Kevin-WSCU/96Boards-Camera/Boards/IMG_3235.jpg

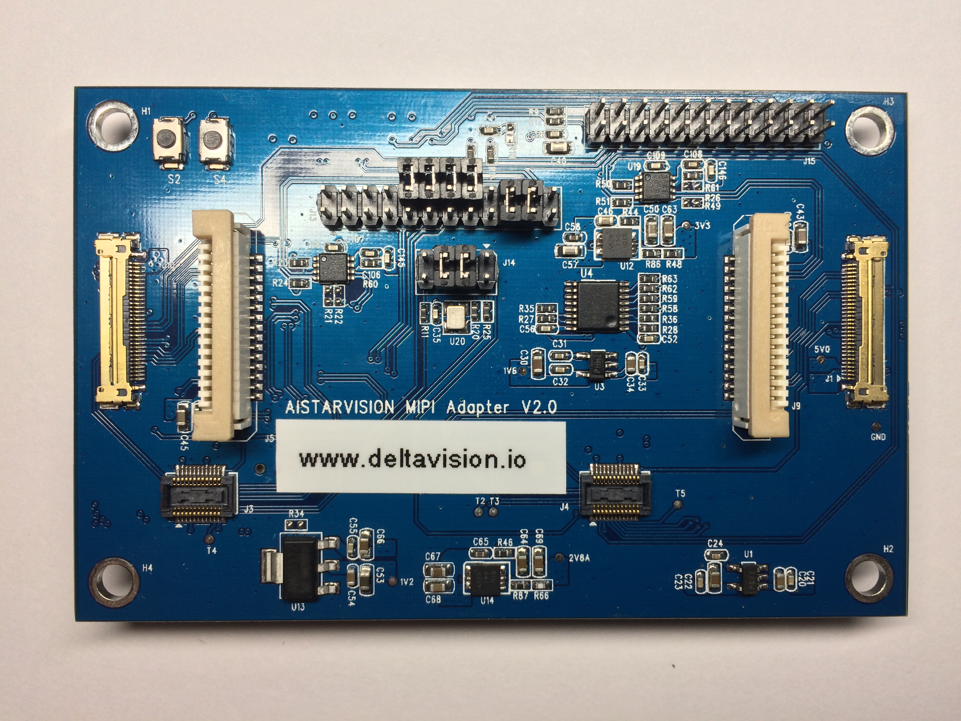
Boards/IMG_3235.jpg
