Kevin-WSCU/96Boards-Camera/Boards/IMG_3196.jpg

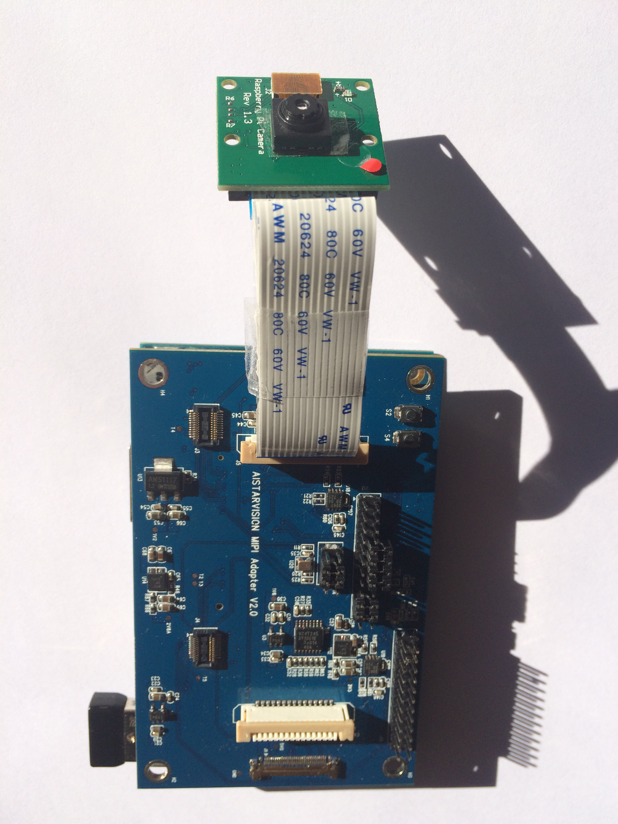
Boards/IMG_3196.jpg
