Kevin-WSCU/96Boards-Camera/README.md

This is the AISTARVISION MIPI Adapter,V2.0! It's updated from V1.0,with the goal of two CSI2 port support.Still,it's only for 96boards CE Edition.Our goal is to make 96Boards support variety of image sensors,include SOC sensor and raw bayer sensor.

P.S. AISTARVISION has joined DeltaVision team which has the same passion and mission to bring camera everywhere,making your project smarter than ever before.Take a look at our site for more interesting cameras:

https://www.deltavision.io

Sensor sample drivers available in Debian 16.09 for Dragonboard410C:[Dragonboard410C Camera](https://github.com/Kevin-WSCU/Debian-169.git)

Image sensor support list(Default on Debian):

1)OV5645:2592*1944@15fps,1920*1080@30fps,1280*960@30fps

2)OV5640:2592*1944@15fps,1920*1080@30fps,1280*960@30fps

3)OV7251:640*480@100fps

4)MT9V024 with Toshiba MIPI Bridge:752*480@60fps

5)IMX185:1080p@60fps

6)AP0202+AR0230:1080p@30fps,WDR

7)OV13850 supported by Android

8)OV8865 supported by Android

9)Raspberry PI camera V1.3(OV5647),supported by Android

10)Raspberry PI camera V1.3(IMX219),supported by Android

11)MT9M034 with Toshiba MIPI Bridge:RAW12

12)MT9M031 with Toshiba MIPI Bridge:RAW12

13)AR0130 with Toshiba MIPI Bridge:RAW12

14)AR0134 with Toshiba MIPI Bridge:RAW12

15)AR0144 :RAW12

16)OV9281:RAW8/RAW10

Check our ebay store for available items: [Deltavision Store on Ebay](https://www.ebay.com/sch/aiwills-8/m.html?item=252956476095&rt=nc&_trksid=p2047675.l2562)

You can find pre-built sensor drivers for all avaiable cameras:[Pre-built](Pre-built)
