Kevin-WSCU/96Boards-Camera/Pre-built/Android_5.1.1/imx219/README

Raspberry imx219 camera module is supported on mipi csi2 15pin interface of Adapter V2.0 Mezzanine board.
