Kevin-WSCU/96Boards-Camera/Pre-built/Android_5.1.1/ov5647/README

Raspberry ov5647 camera module is supported on 15pin mipi csi2 interface of Adapter V2.0 Mezzanine board.
