Kevin-WSCU/96Boards-Camera/Pre-built/Android_5.1.1/Dual_concurrent_ov5645/README

1.Android 5.1.1 image location

http://builds.96boards.org/releases/dragonboard410c/qualcomm/android/16.03/
download dragonboard410c_sdcard_install_android-99.zip

2.Source code

  ** Qualcomm BSP

    https://developer.qualcomm.com/download/db410c/android_board_support_package_vla.br_.1.2.4-01810-8x16.0-3.zip

  ** Aurora Code download guide

    https://developer.qualcomm.com/download/db410c/linux-android-software-build-and-installation-guide.pdf

3.Modification

  ** software:

    Fastboot flash boot boot_dual_concurrent_ov5645.img
    adb push libmmcamera_ov5645_rear.so
    adb push libmmcamera2_isp_modules.so
    adb push liboemcamera.so
    adb push libmmcamera2_iface_modules.so

  ** hardware(refer to AISTARVISION MIPI Adapter V2.0_release.pdf):

    Rear ov5645 module is connected to J3 on MIPI adapter, connect I2C2_SDA/SCL to CAM1_SDA/SCL on MIPI adapter V2.0.
    Front ov5645 module is connected to J4 on MIPI adapter, connect I2C2_SDA/SCL to CAM2_SDA/SCL on MIPI adapter V2.0.
