Kevin-WSCU/96Boards-Camera/Boards/IMG_2752.jpg

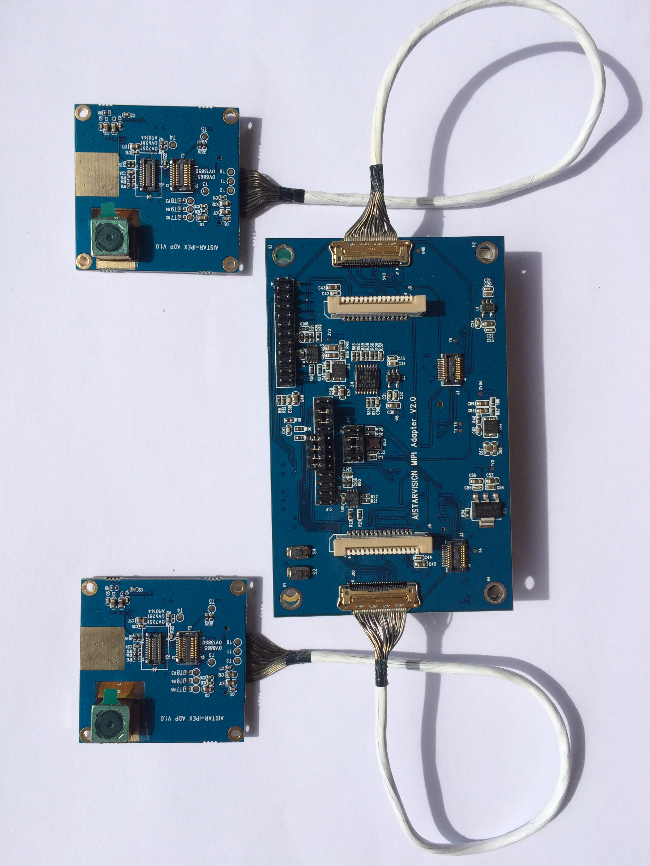
Boards/IMG_2752.jpg
