Kevin-WSCU/96Boards-Camera/Boards/IMG_3036.jpg

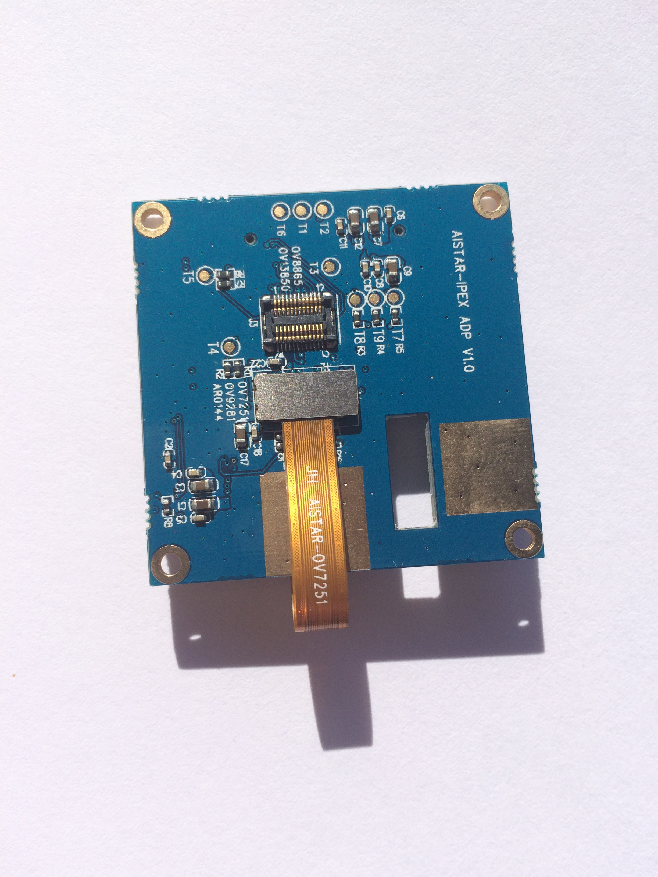
Boards/IMG_3036.jpg
