Kevin-WSCU/96Boards-Camera/Boards/IMG_3037.jpg

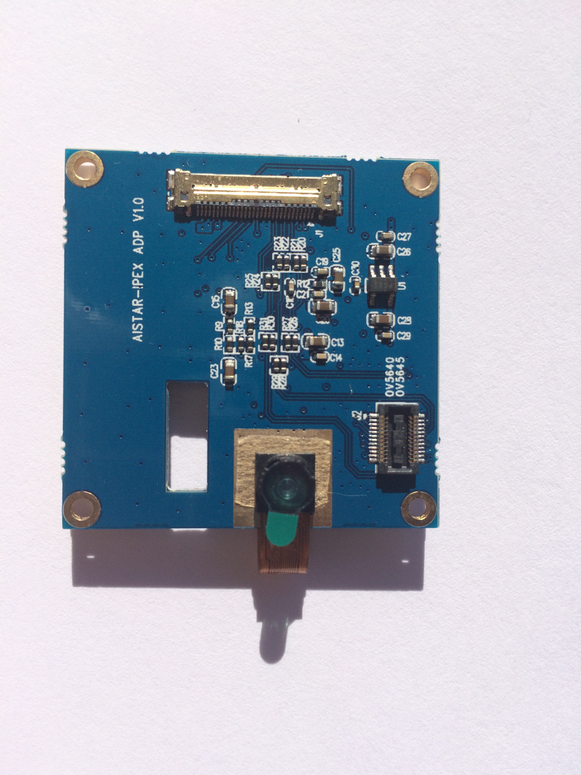
Boards/IMG_3037.jpg
