Kevin-WSCU/96Boards-Camera/Boards/IMG_3038.jpg

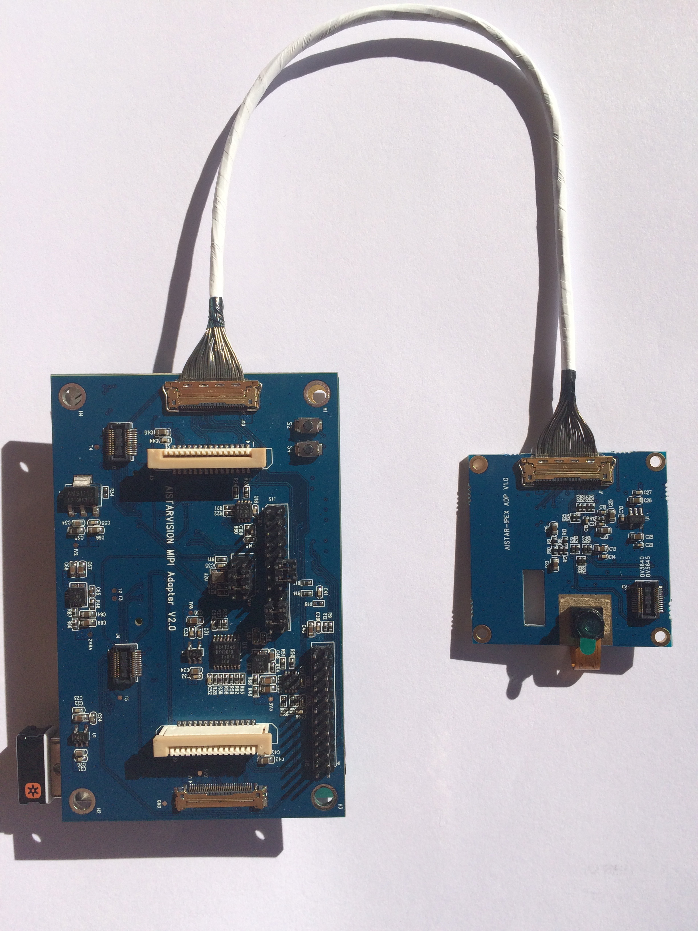
Boards/IMG_3038.jpg
