Kevin-WSCU/96Boards-Camera/Boards/IMG_3039.jpg

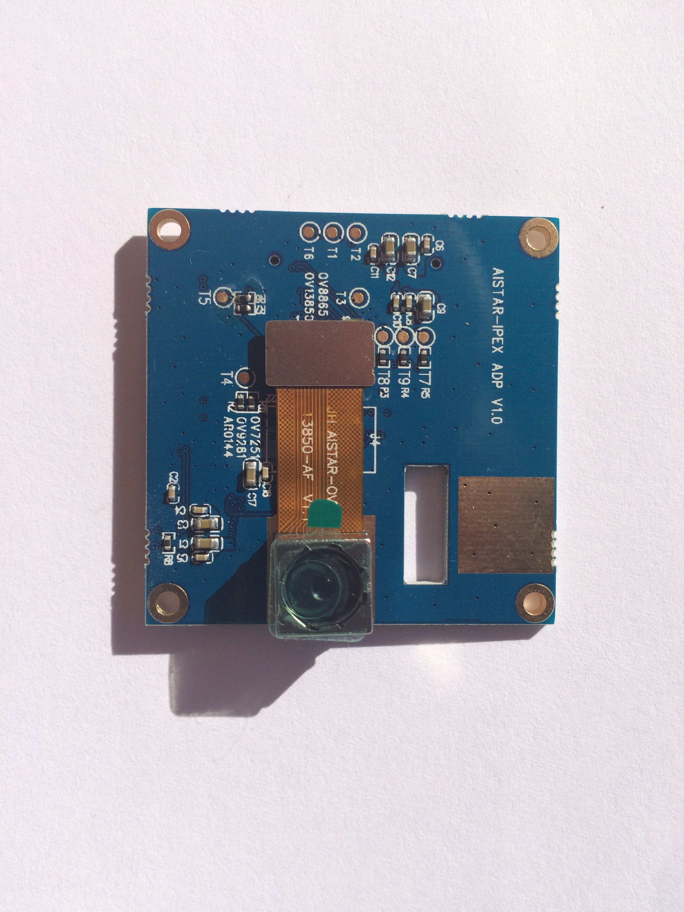
Boards/IMG_3039.jpg
