Kevin-WSCU/96Boards-Camera/Boards/IMG_3040.jpg

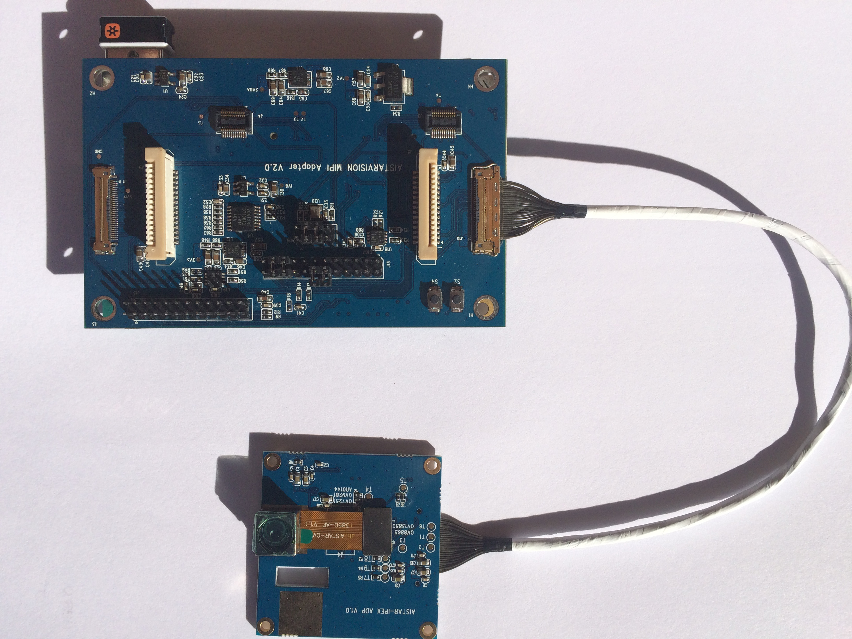
Boards/IMG_3040.jpg
