Kevin-WSCU/96Boards-Camera/Boards/IMG_3052.jpg

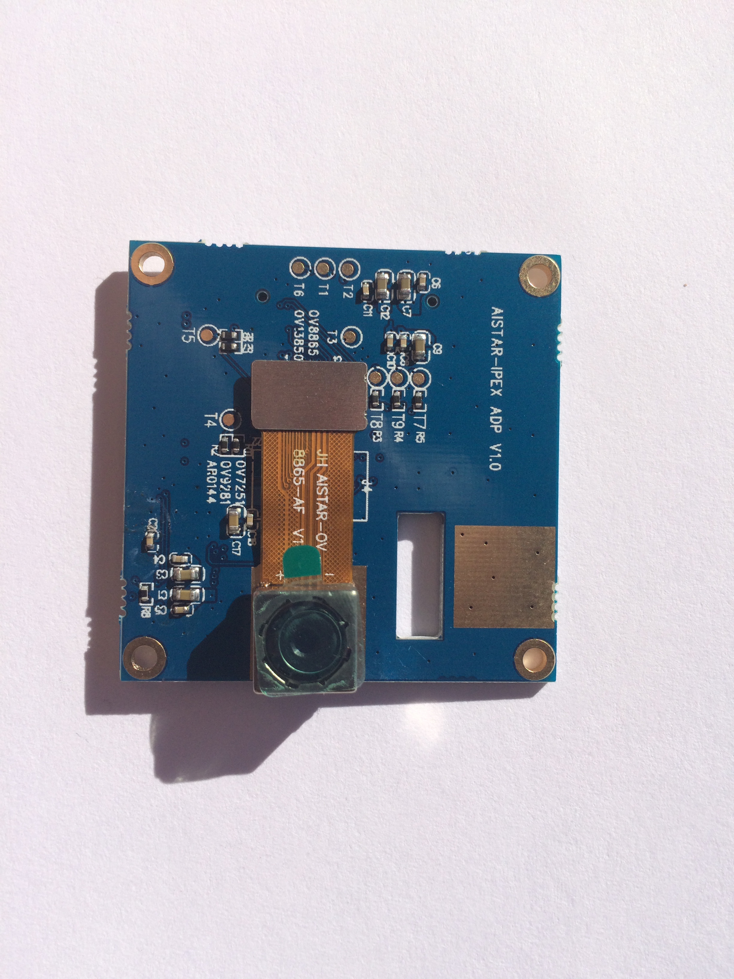
Boards/IMG_3052.jpg
