Kevin-WSCU/96Boards-Camera/Boards/IMG_3053.jpg

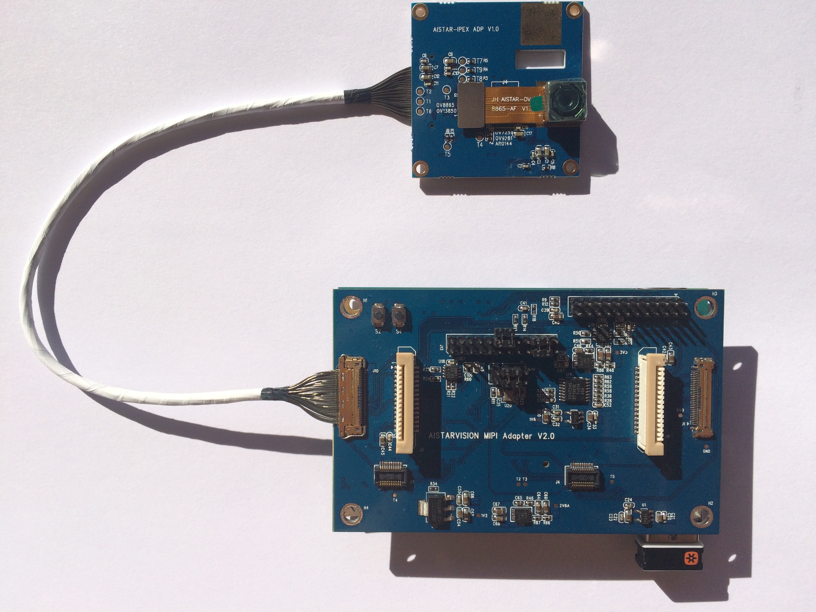
Boards/IMG_3053.jpg
