Kevin-WSCU/96Boards-Camera/Boards/IMG_3056.jpg

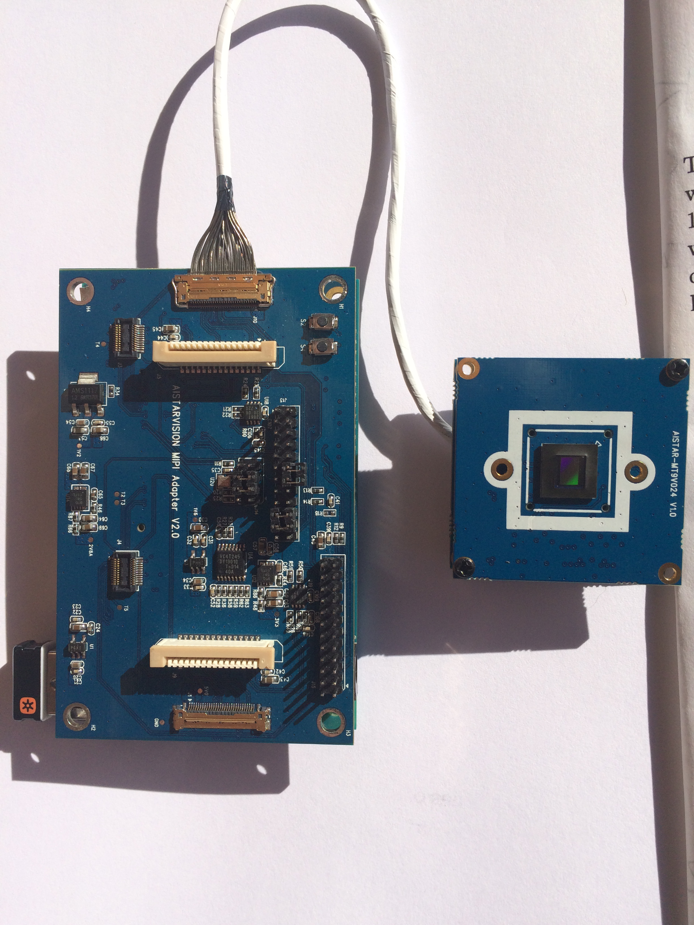
Boards/IMG_3056.jpg
