Kevin-WSCU/96Boards-Camera/Boards/IMG_3057.jpg

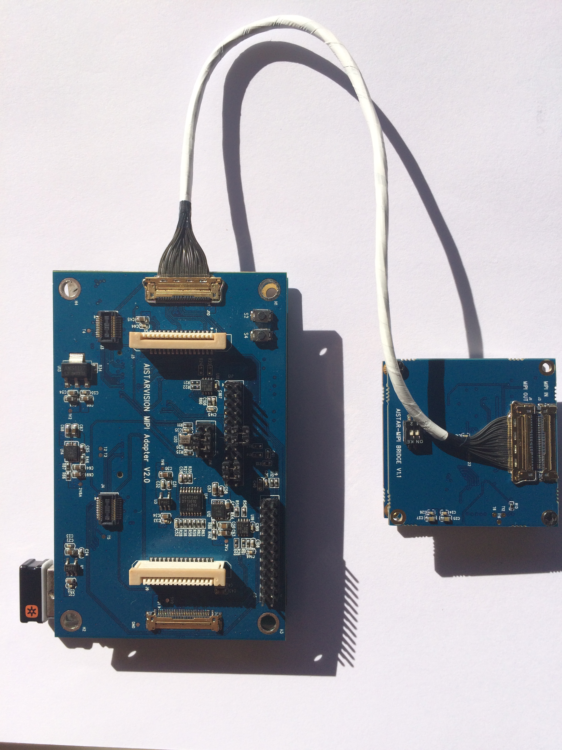
Boards/IMG_3057.jpg
