Kevin-WSCU/96Boards-Camera/Boards/IMG_3221.jpg

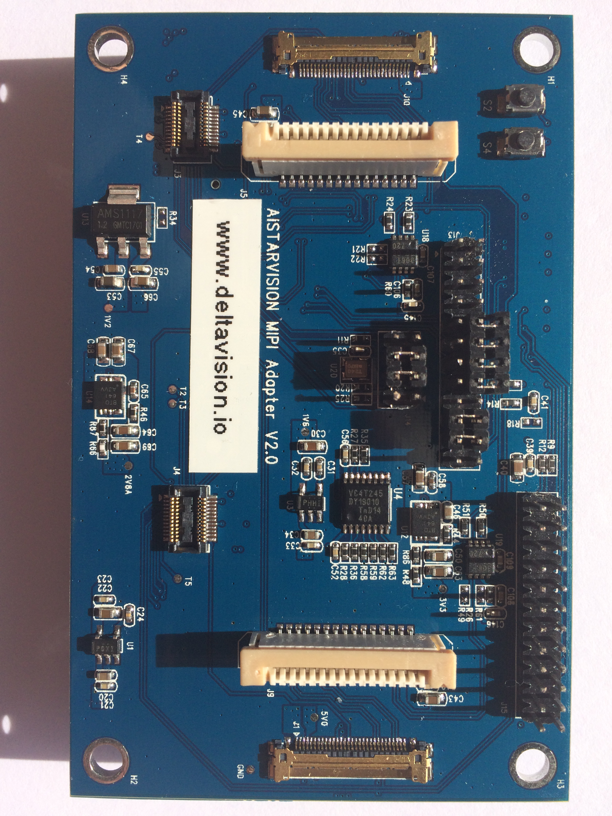
Boards/IMG_3221.jpg
