Kevin-WSCU/96Boards-Camera/Boards/IMG_3222.jpg

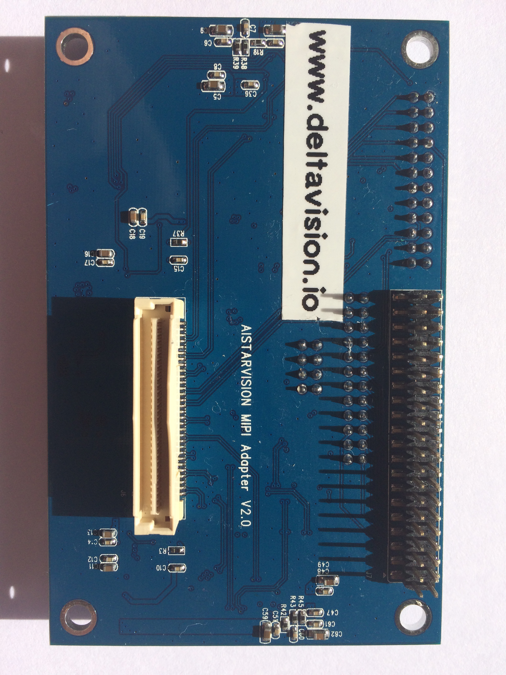
Boards/IMG_3222.jpg
