Kevin-WSCU/96Boards-Camera/Boards/IMG_3230.jpg

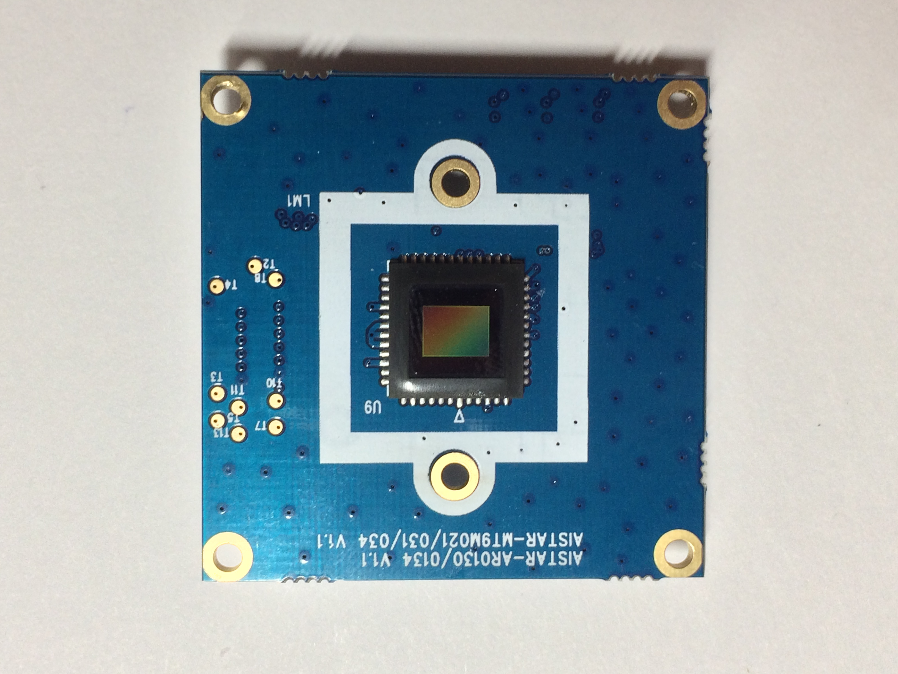
Boards/IMG_3230.jpg
