Kevin-WSCU/96Boards-Camera/Boards/IMG_3237.jpg

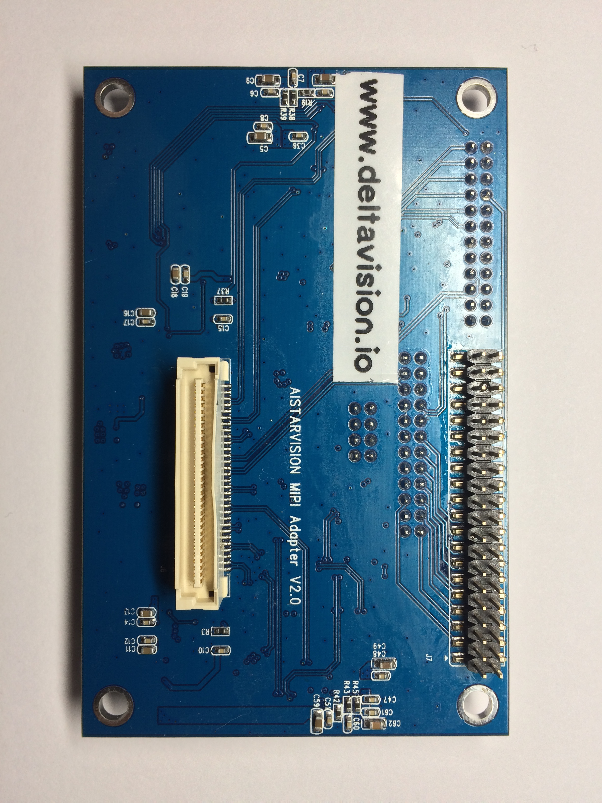
Boards/IMG_3237.jpg
