Kevin-WSCU/96Boards-Camera/Boards/IMG_3243.jpg

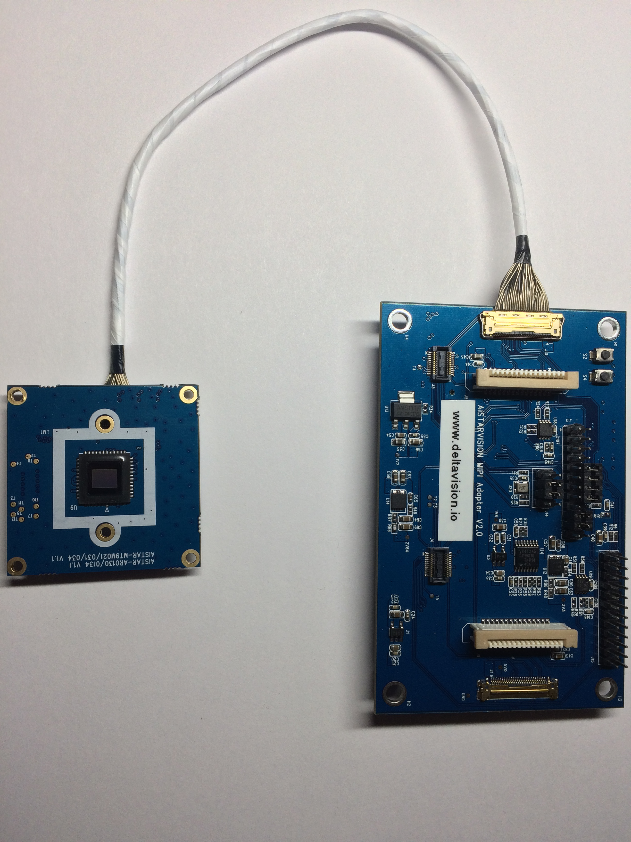
Boards/IMG_3243.jpg
