Kevin-WSCU/96Boards-Camera/Pre-built/Android_5.1.1/Dual_concurrent_ov5645/dual_concurrent_ov5645_preview.jpg

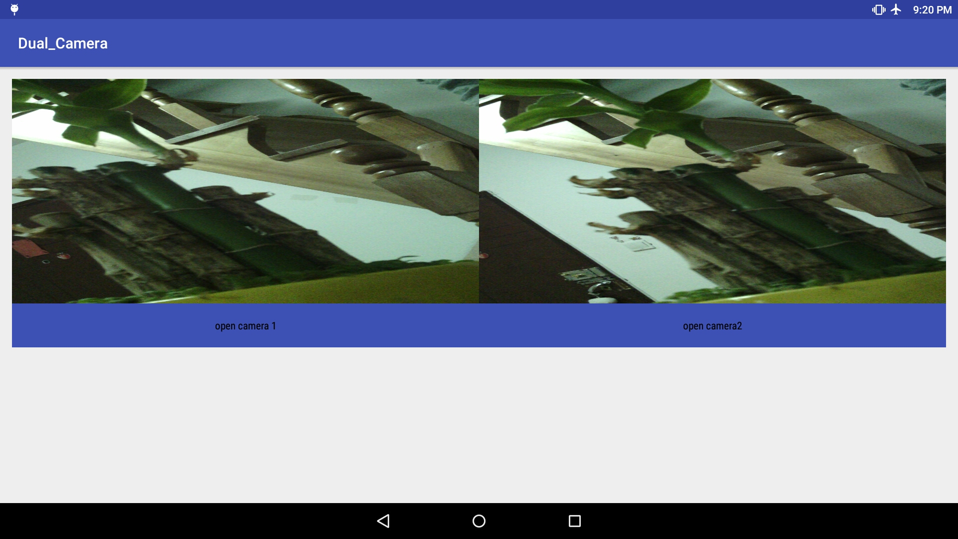
Pre-built/Android_5.1.1/Dual_concurrent_ov5645/dual_concurrent_ov5645_preview.jpg
