Kevin-WSCU/96Boards-Camera/SensorModuleSpec/AISTAR-MIPI-Bridge V1.2.pdf

1.8V IO | 3.3V IO

## DIR=0, A<-B

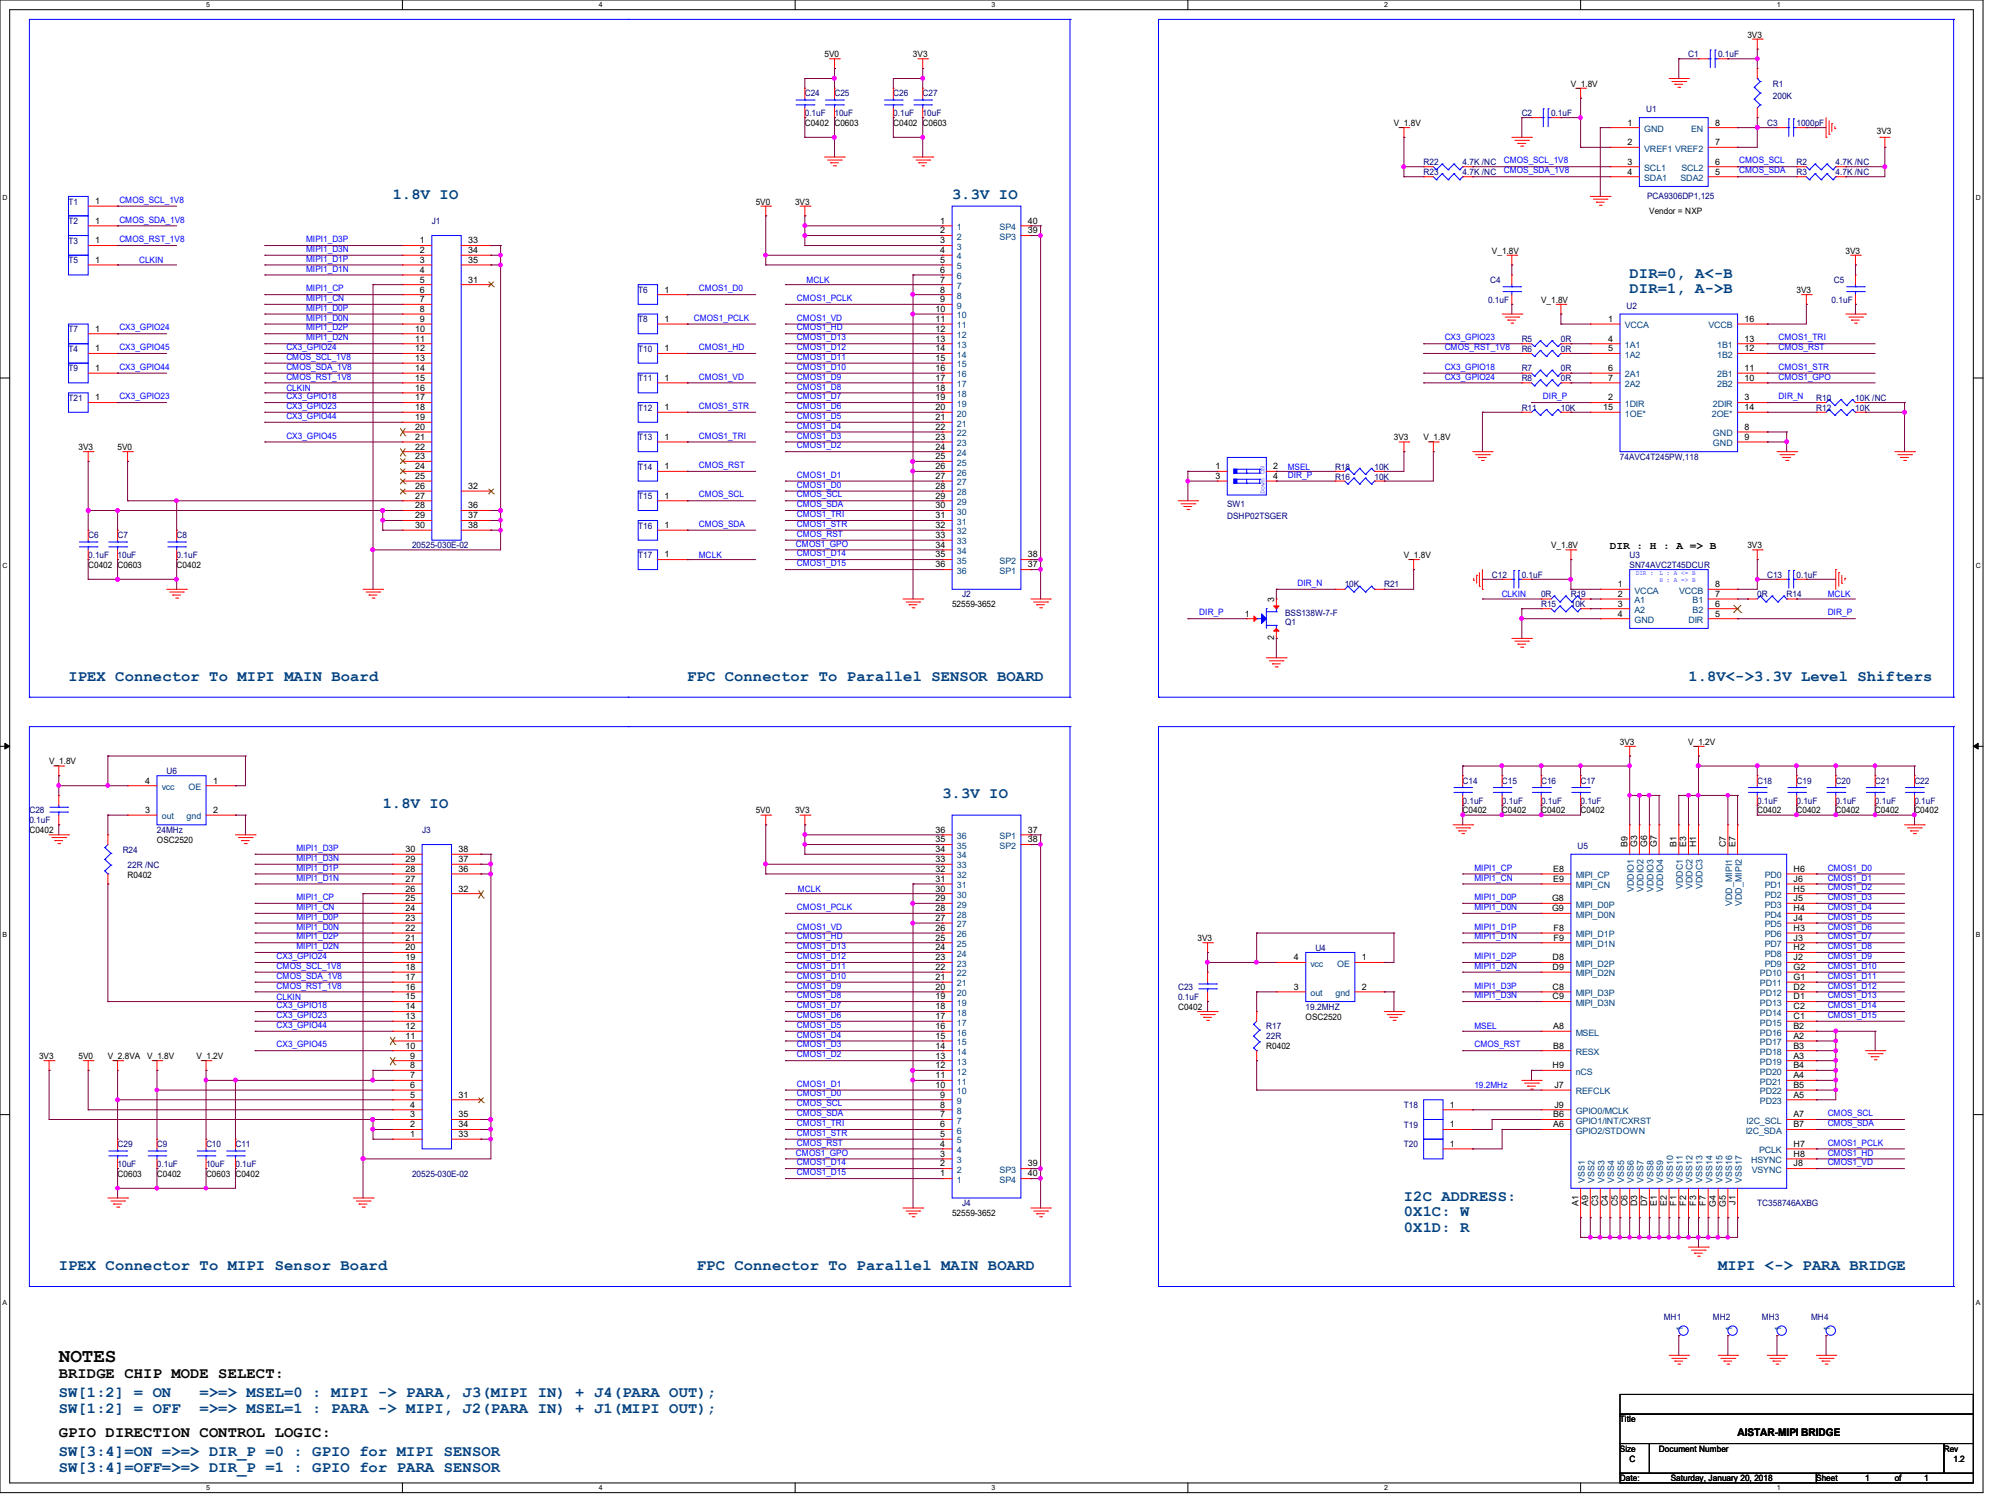
[picture p27: page 1]

IPEX Connector To MIPI MAIN Board

FPC Connector To Parallel SENSOR BOARD

IPEX Connector To MIPI Sensor Board

FPC Connector To Parallel MAIN BOARD

NOTES
BRIDGE CHIP MODE SELECT:

GPIO DIRECTION CONTROL LOGIC:
SW[3:4]=ON =>=> DIR_P =0 : GPIO for MIPI SENSOR
SW[3:4]=OFF=>=> DIR_P =1 : GPIO for PARA SENSOR

5

4

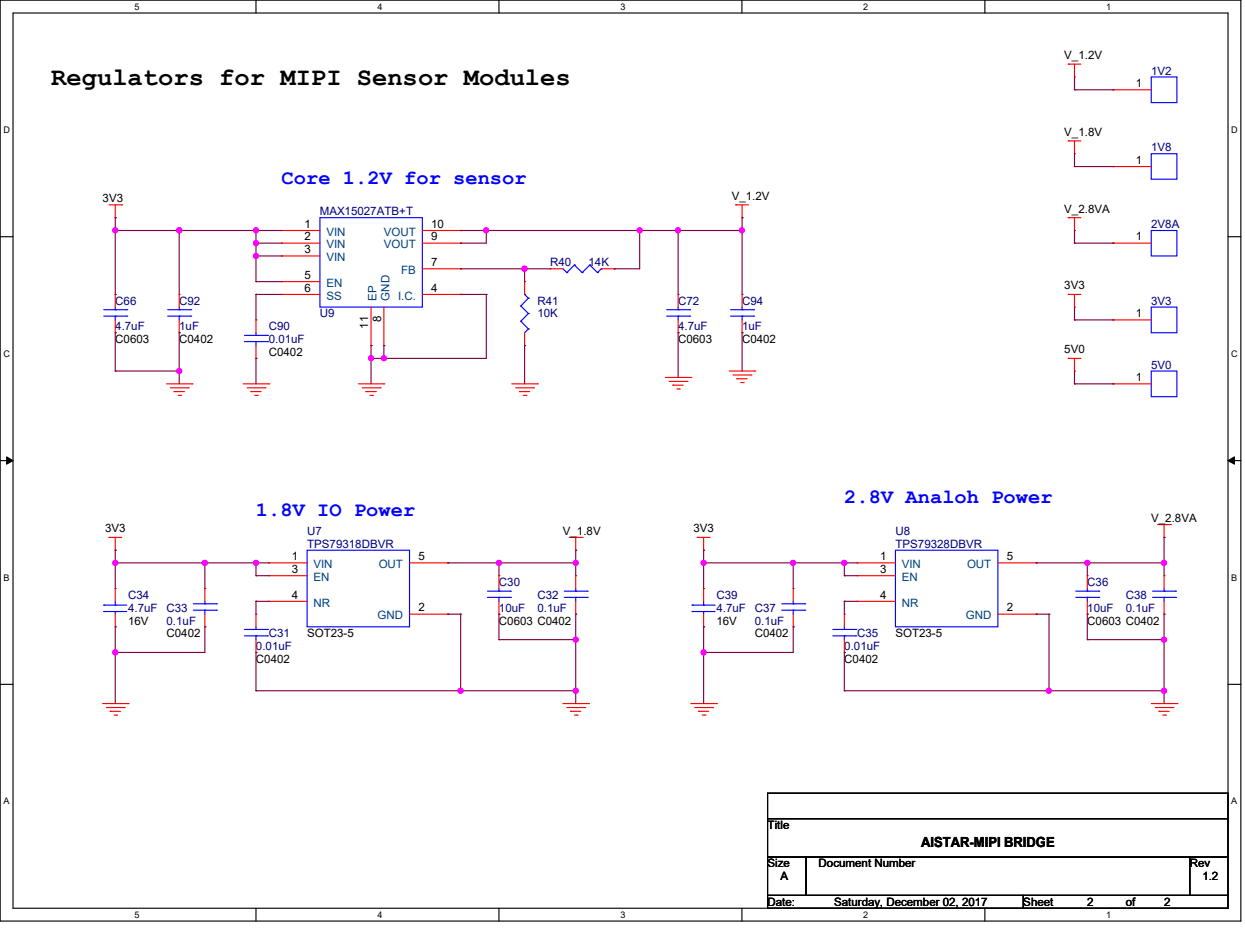
[picture p28: page 2]

Regulators for MIPI Sensor Modules

GND 8 VOUT 9 VOUT 10 EP 11
