Kevin-WSCU/96Boards-Camera/SensorModuleSpec/AISTAR-AR0134 V1.1.pdf

## FPC CONNECTOR PARALLEL OUT 2.8V IO

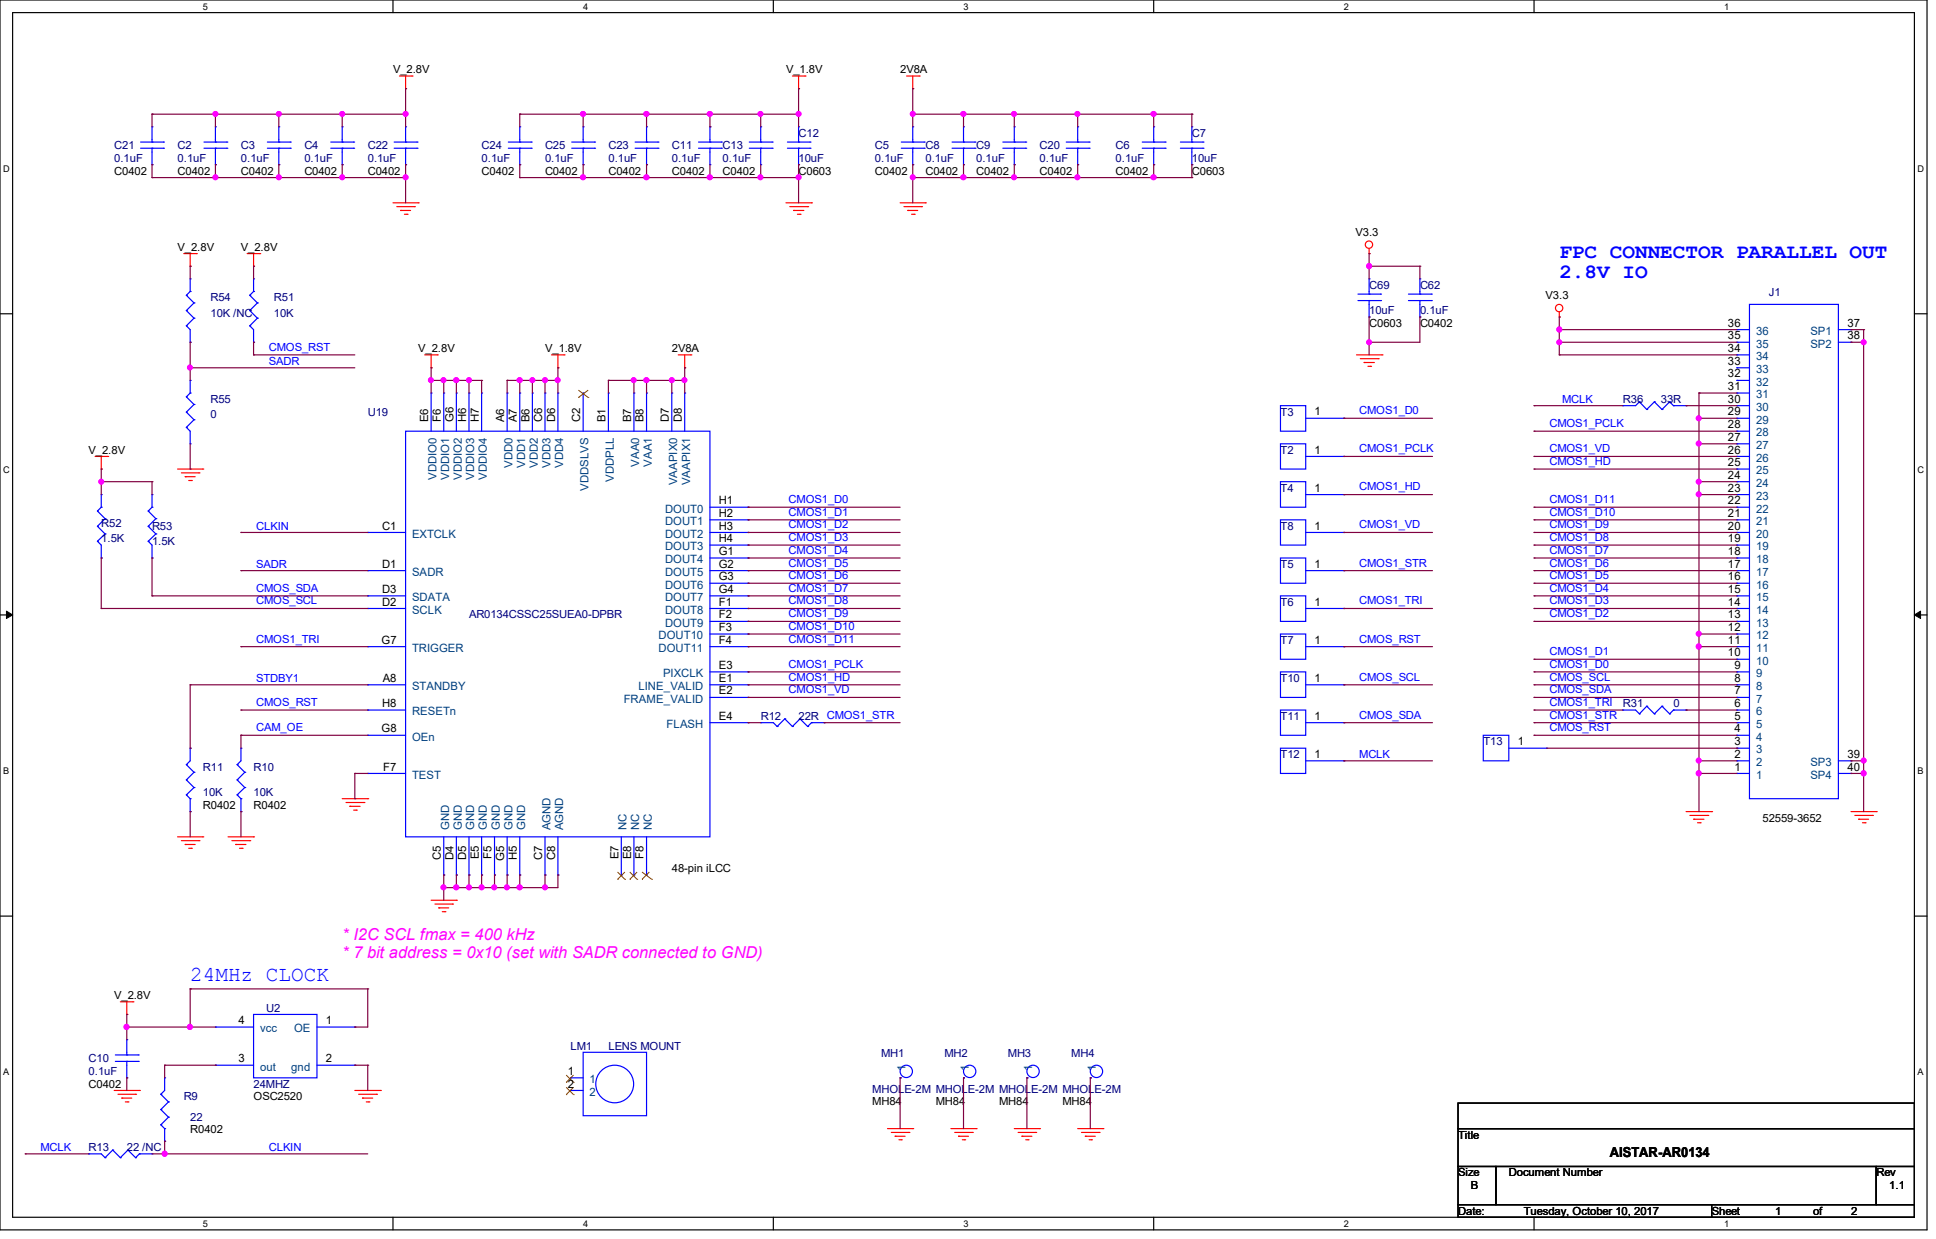
[picture p29: page 1]

* I2C SCL fmax = 400 kHz
* 7 bit address = 0x10 (set with SADR connected to GND)

| | LDO:200mA Max Output U5
V3.3 | V_2.8V

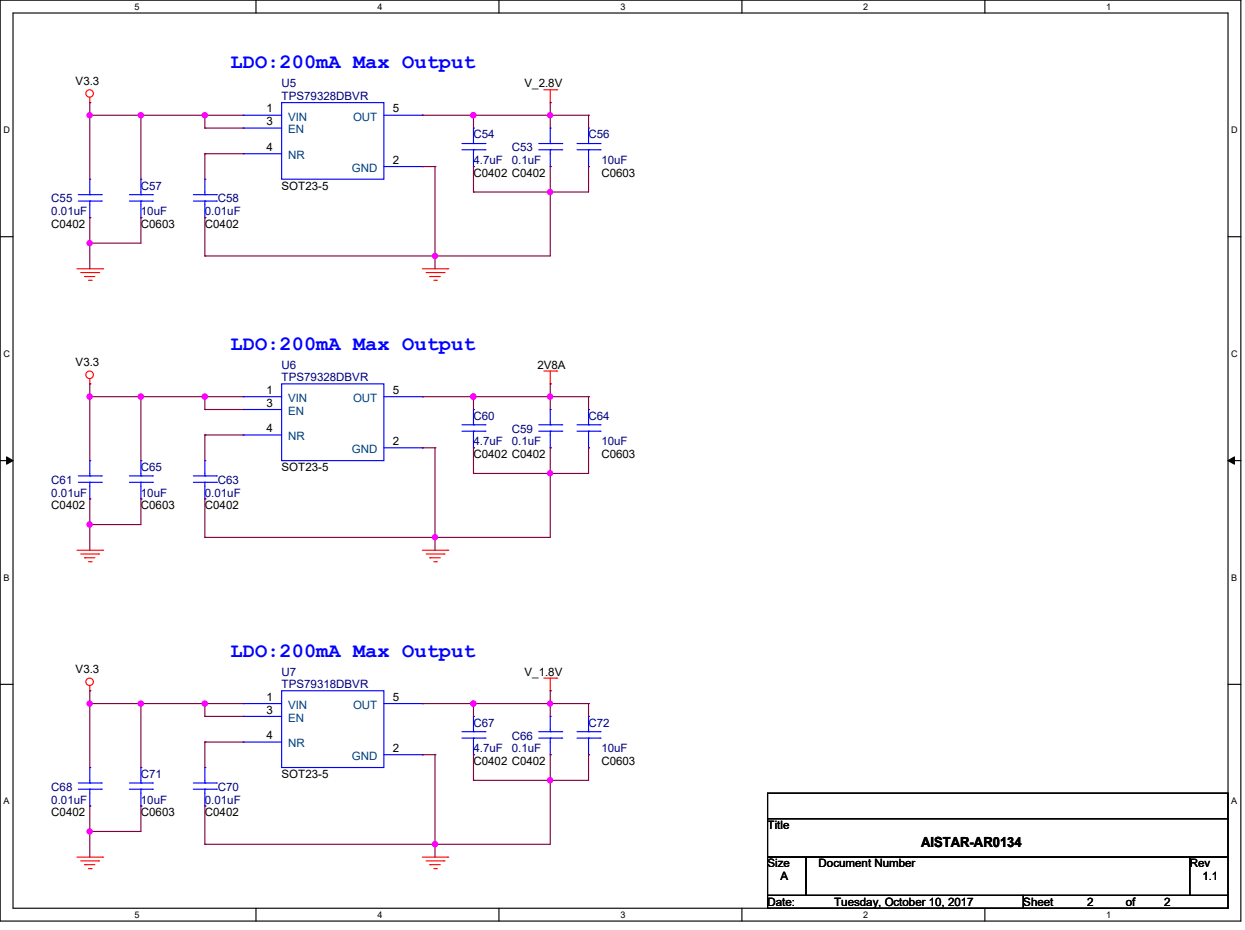
[picture p30: page 2]

LDO:200mA Max Output U6
