Kevin-WSCU/96Boards-Camera/SensorModuleSpec/AISTAR-IPEX-ModuleAdapter V1.0.pdf

## IPEX Connector To MIPI MAIN Board 1.8V IO

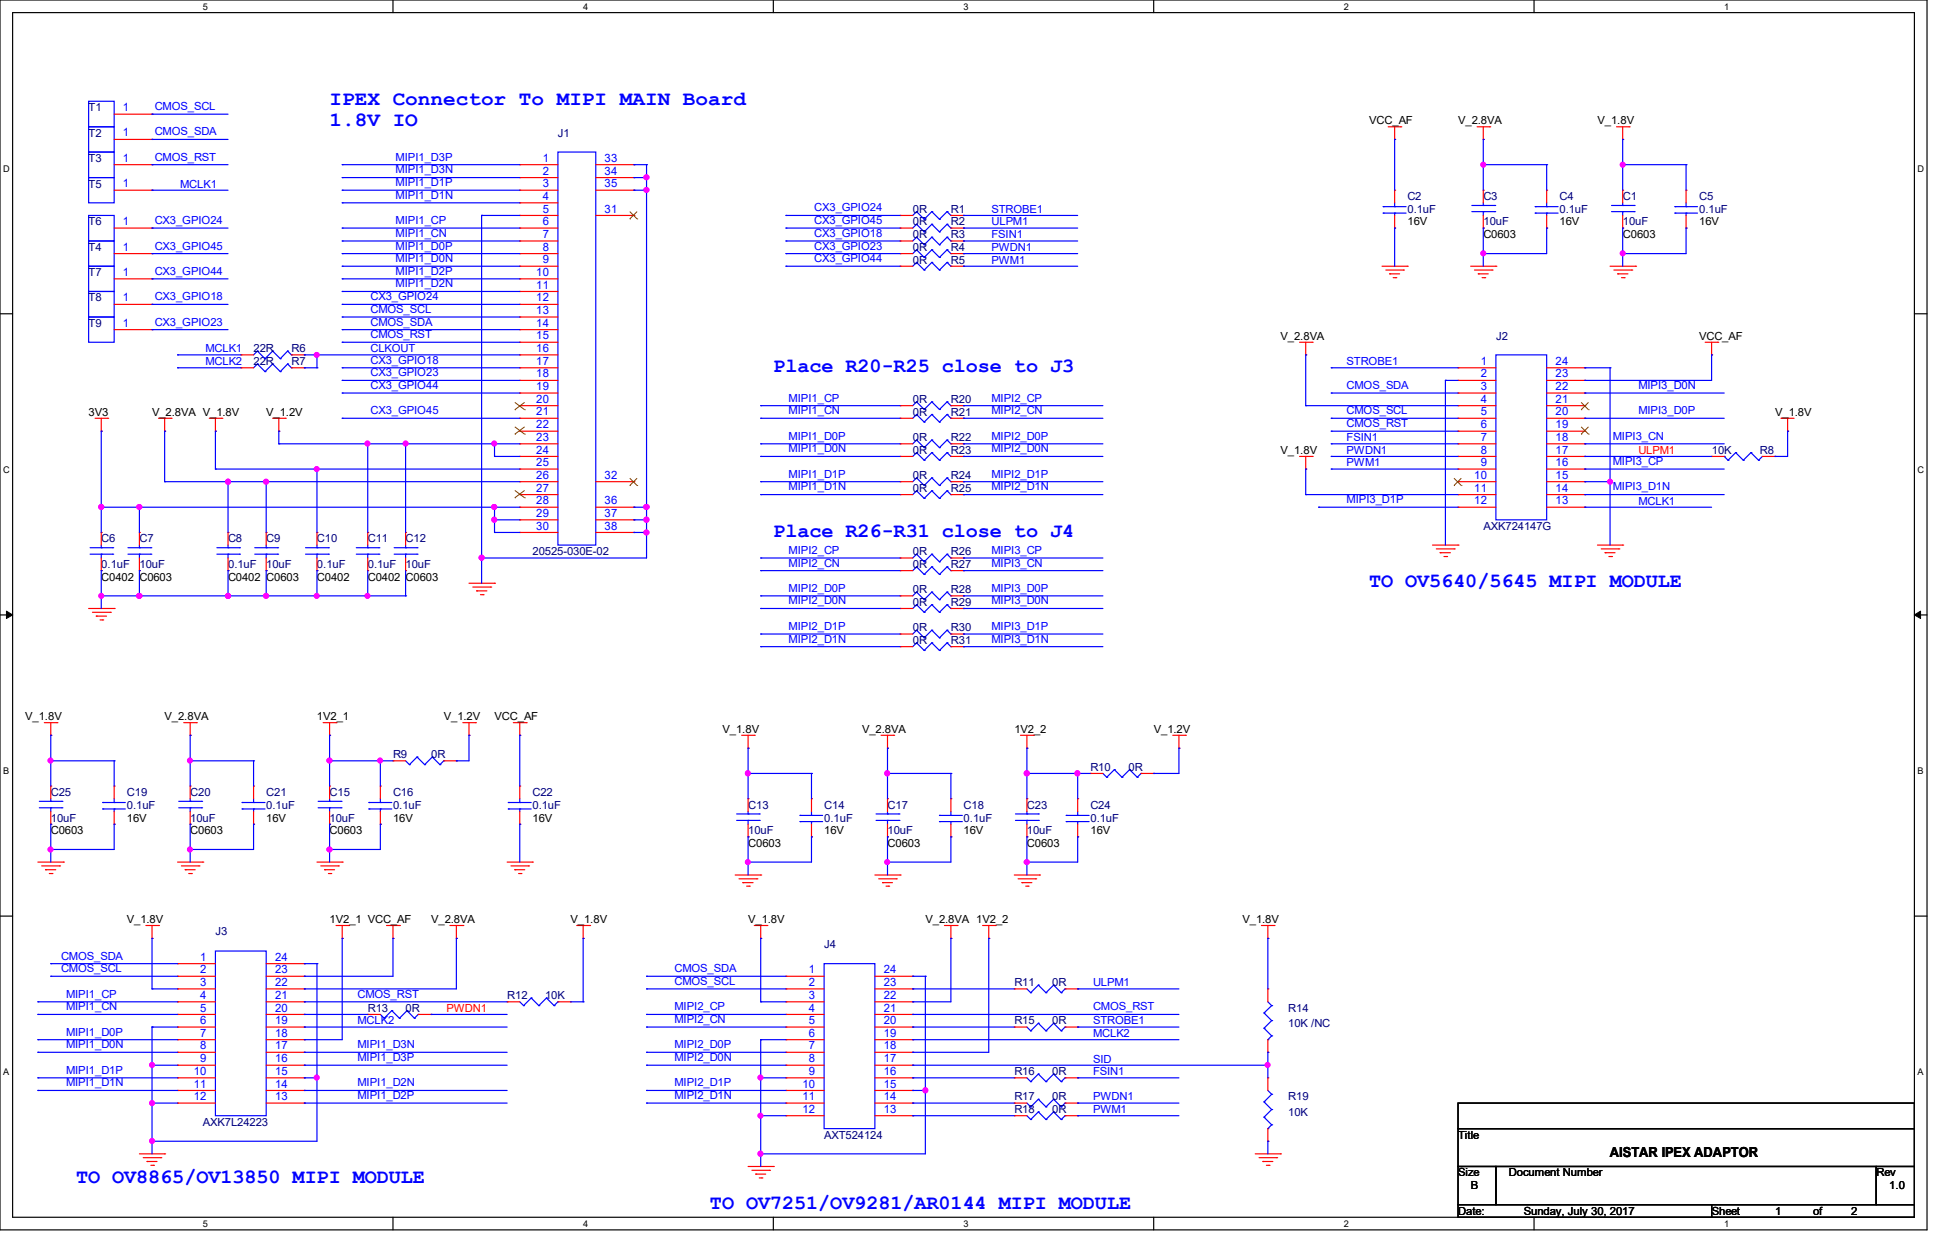
[picture p31: page 1]

# 2.8V for Auto Focus Lens in OV5640/OV5645 Module

3V3 | VCC_AF

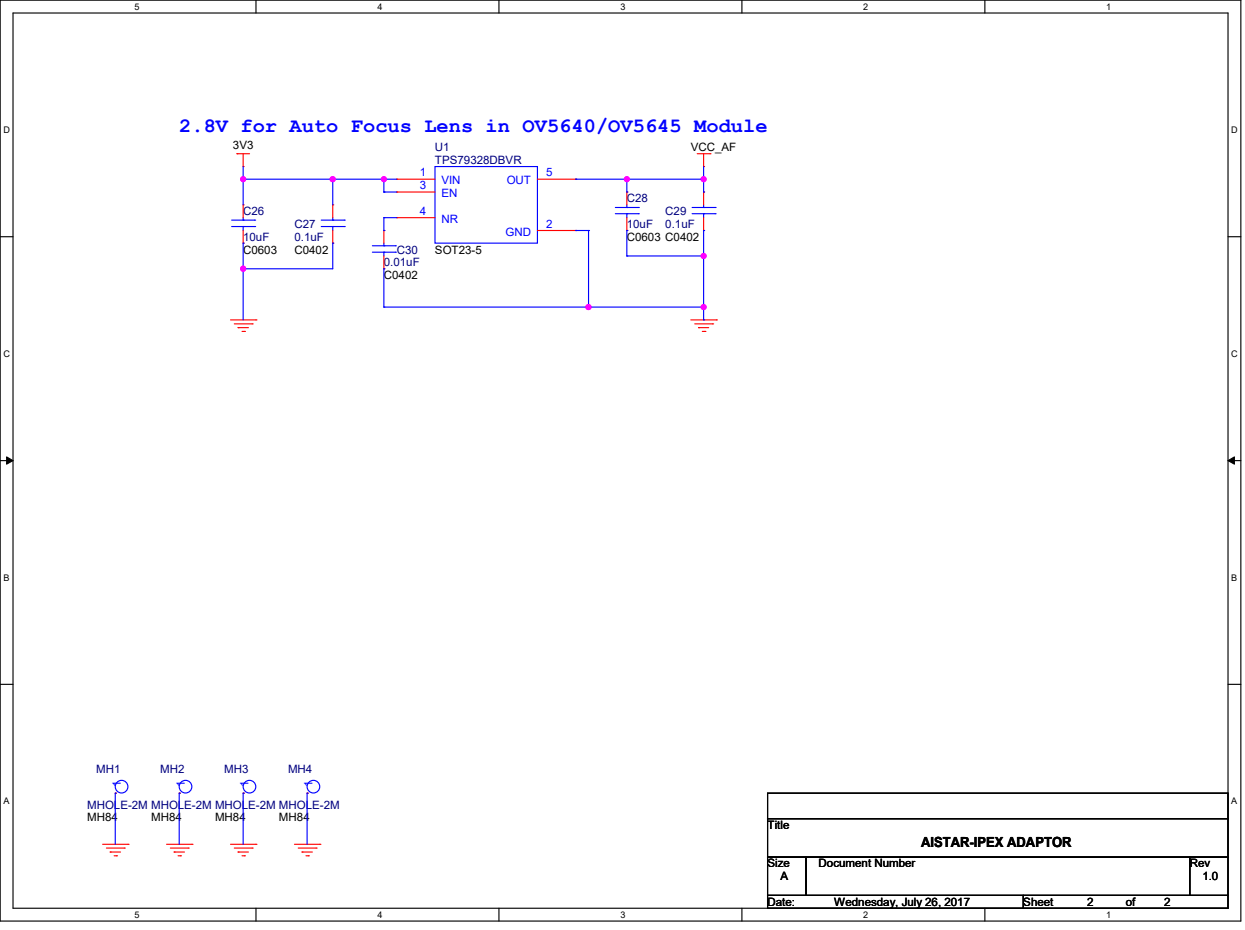
[picture p32: page 2]
