Kevin-WSCU/96Boards-Camera/SensorModuleSpec/AISTAR-MIPI BRIDGE V1.1.pdf

## DIR=0, A<-B DIR=1, A->B

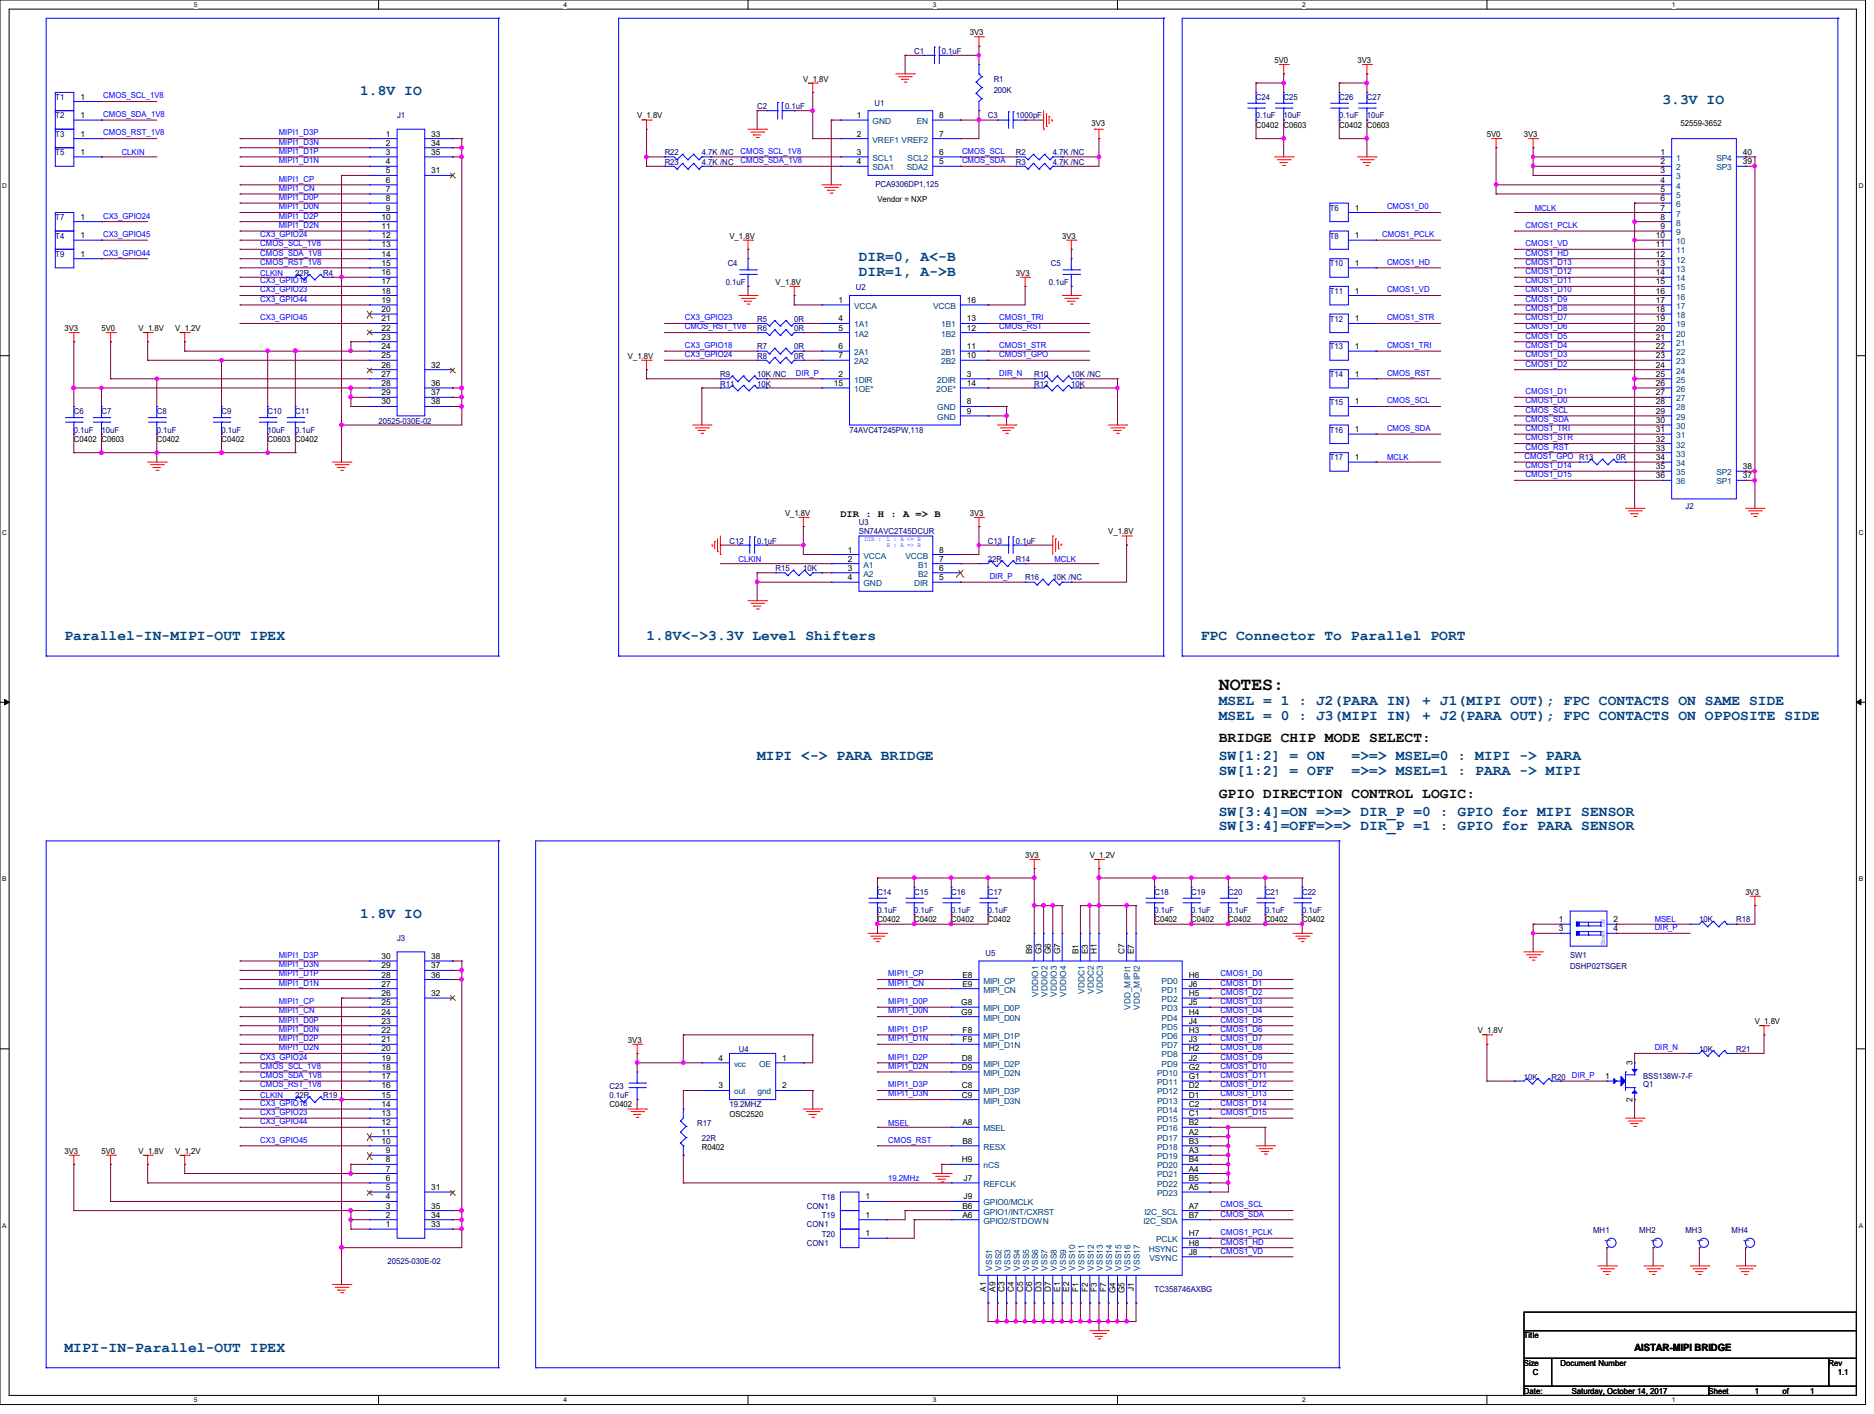
[picture p33: page 1]

Parallel-IN-MIPI-OUT IPEX

NOTES:
MSEL = 1 : J2(PARA IN) + J1(MIPI OUT); FPC CONTACTS ON SAME SIDE
MSEL = 0 : J3(MIPI IN) + J2(PARA OUT); FPC CONTACTS ON OPPOSITE SIDE

BRIDGE CHIP MODE SELECT:

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

MIPI-IN-Parallel-OUT IPEX
