Kevin-WSCU/96Boards-Camera/SensorModuleSpec/AISTAR-MT9V024 V1.0.pdf

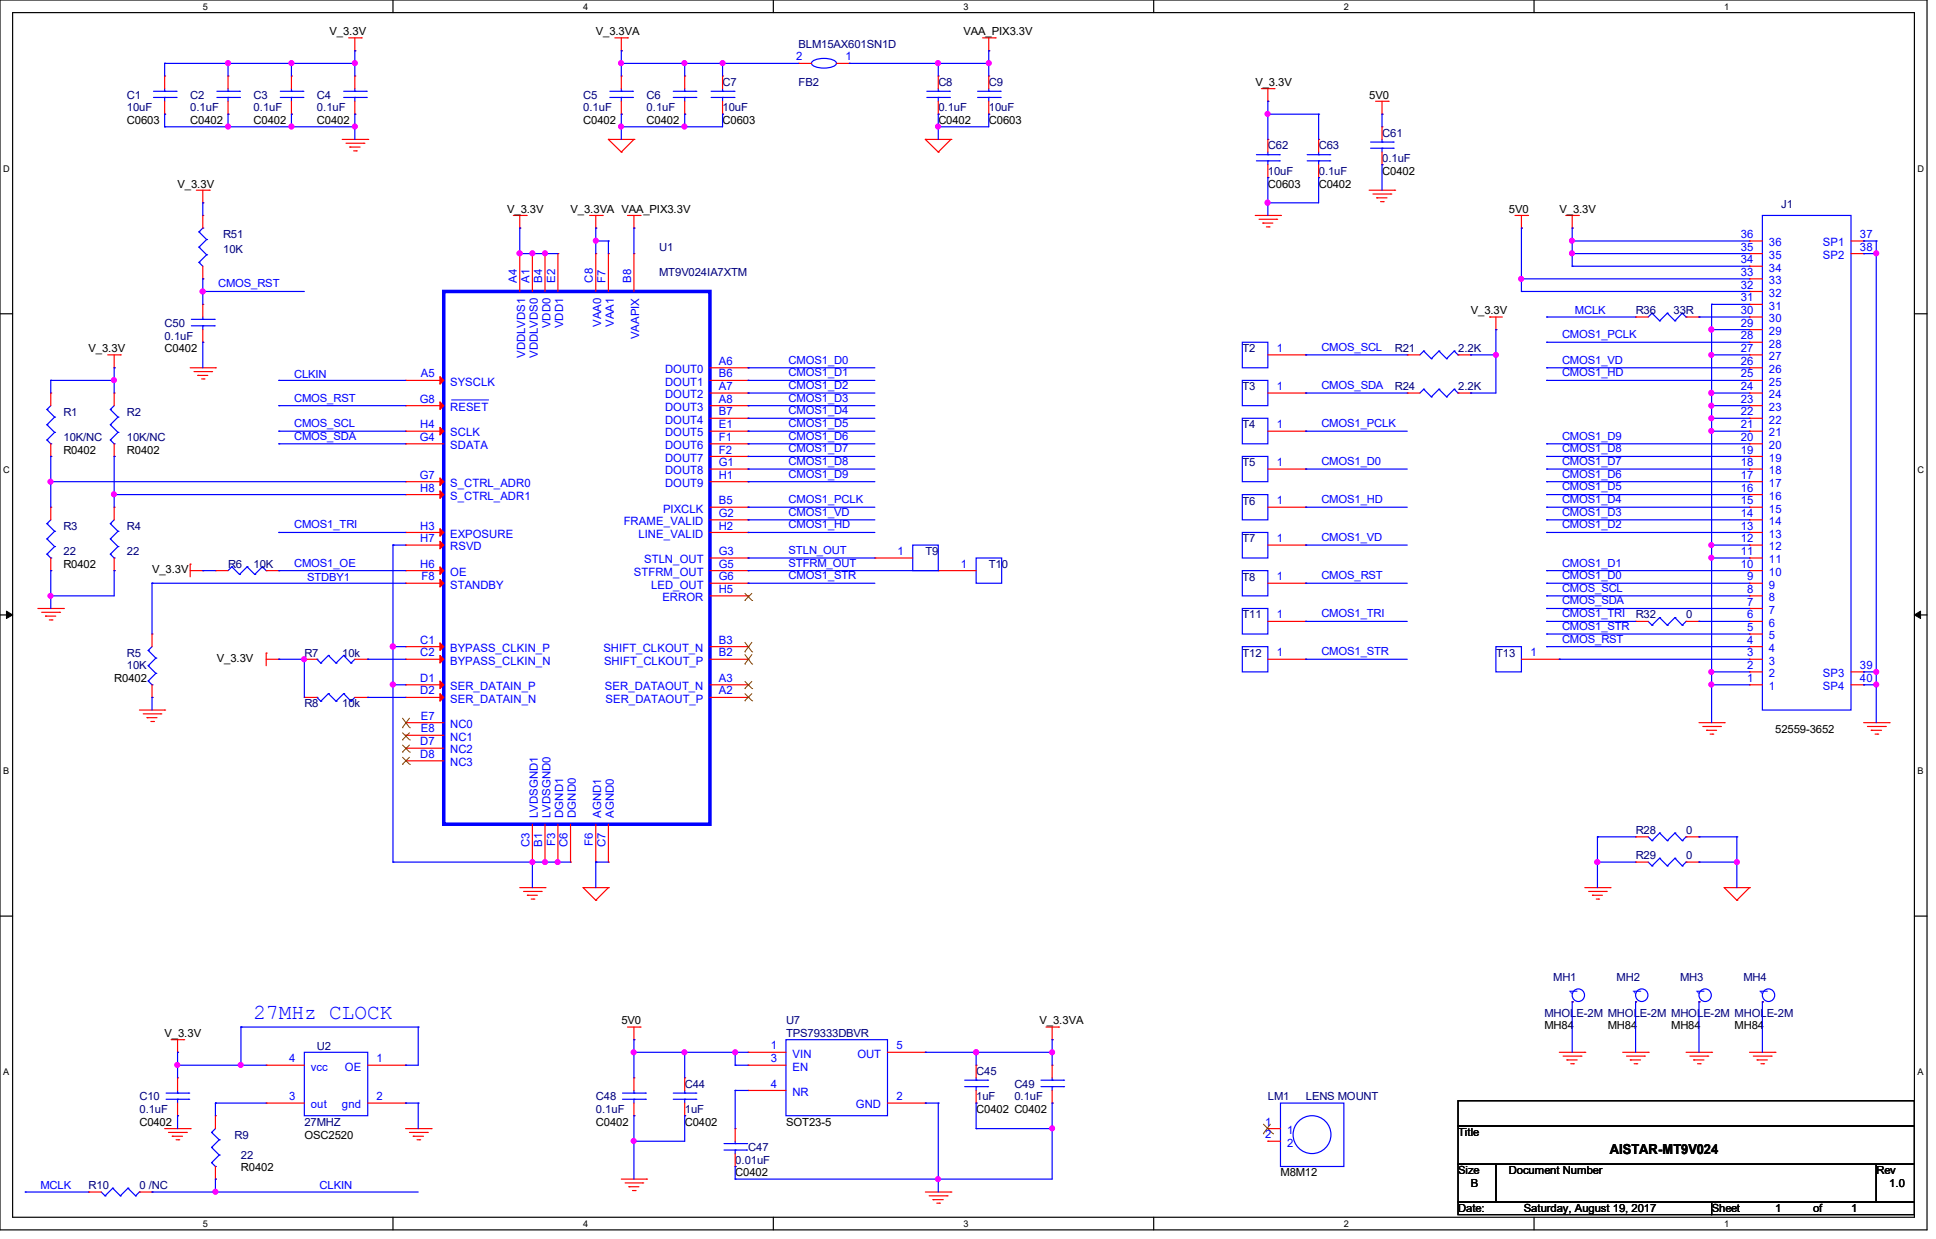
[picture p34: page 1]
