Kevin-WSCU/96Boards-Camera/AISTARVISION MIPI Adapter V2.0/AISTARVISION MIPI Adapter V2.0_release.pdf

To IPEX Camera Board #2 | (1.8V IO)
To IPEX Camera Board #1 | (1.8V IO)

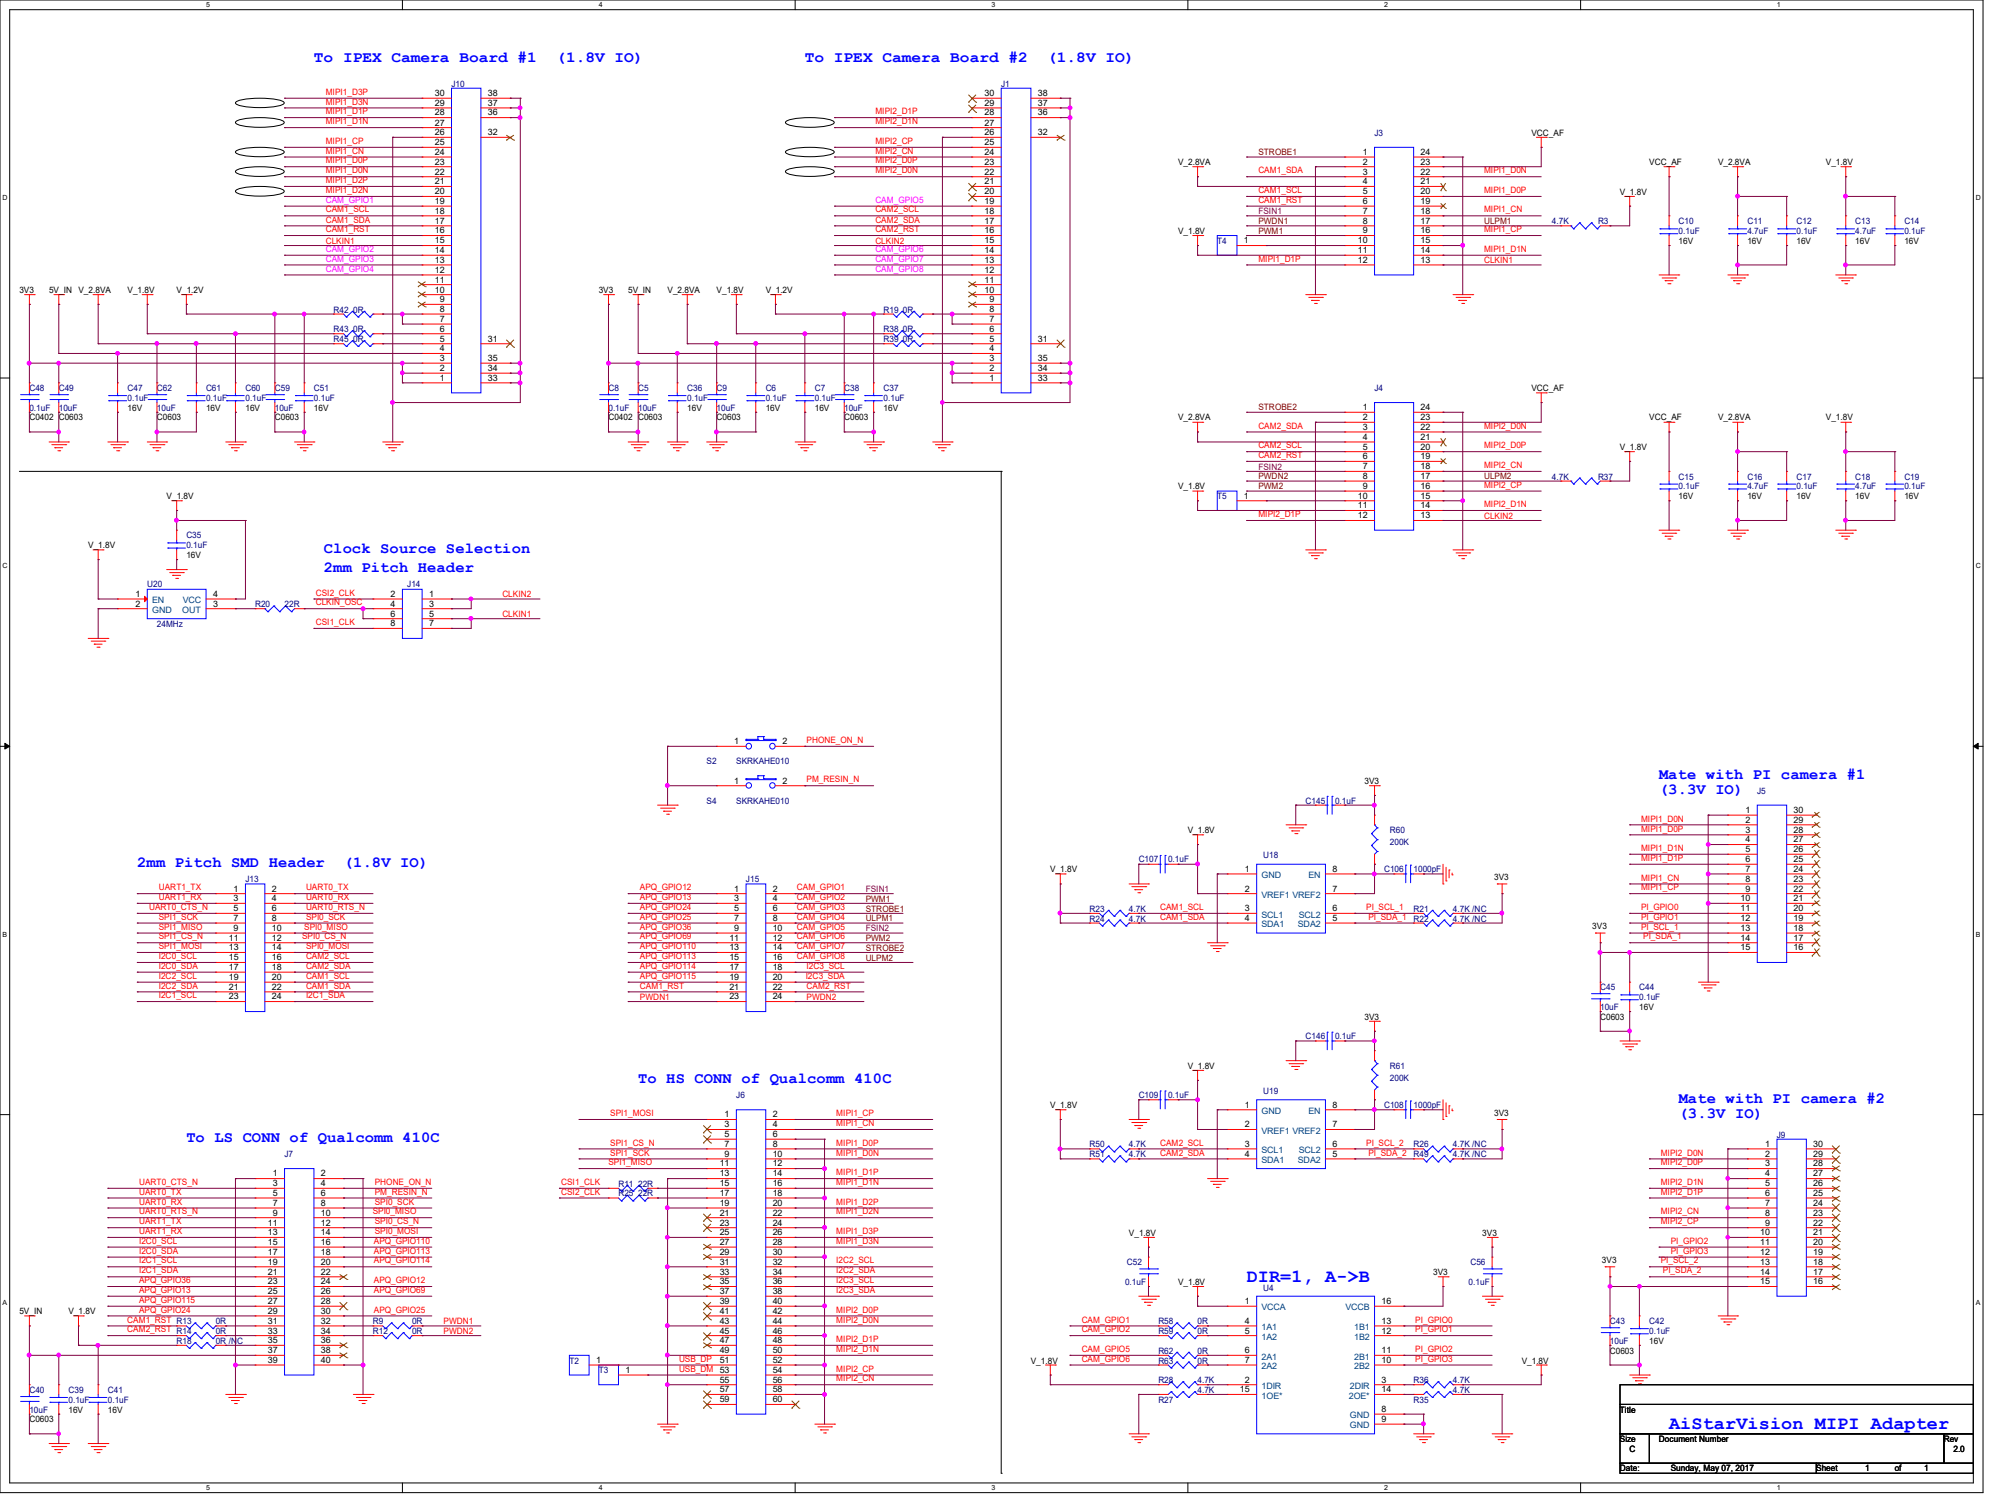
[picture p35: page 1]

Mate with PI camera #1

To HS CONN of Qualcomm 410C

Mate with PI camera #2

To LS CONN of Qualcomm 410C

# 2.8V for Auto Focus Lens in OV5640/OV5645 Module

# 3.3V for Camera Board

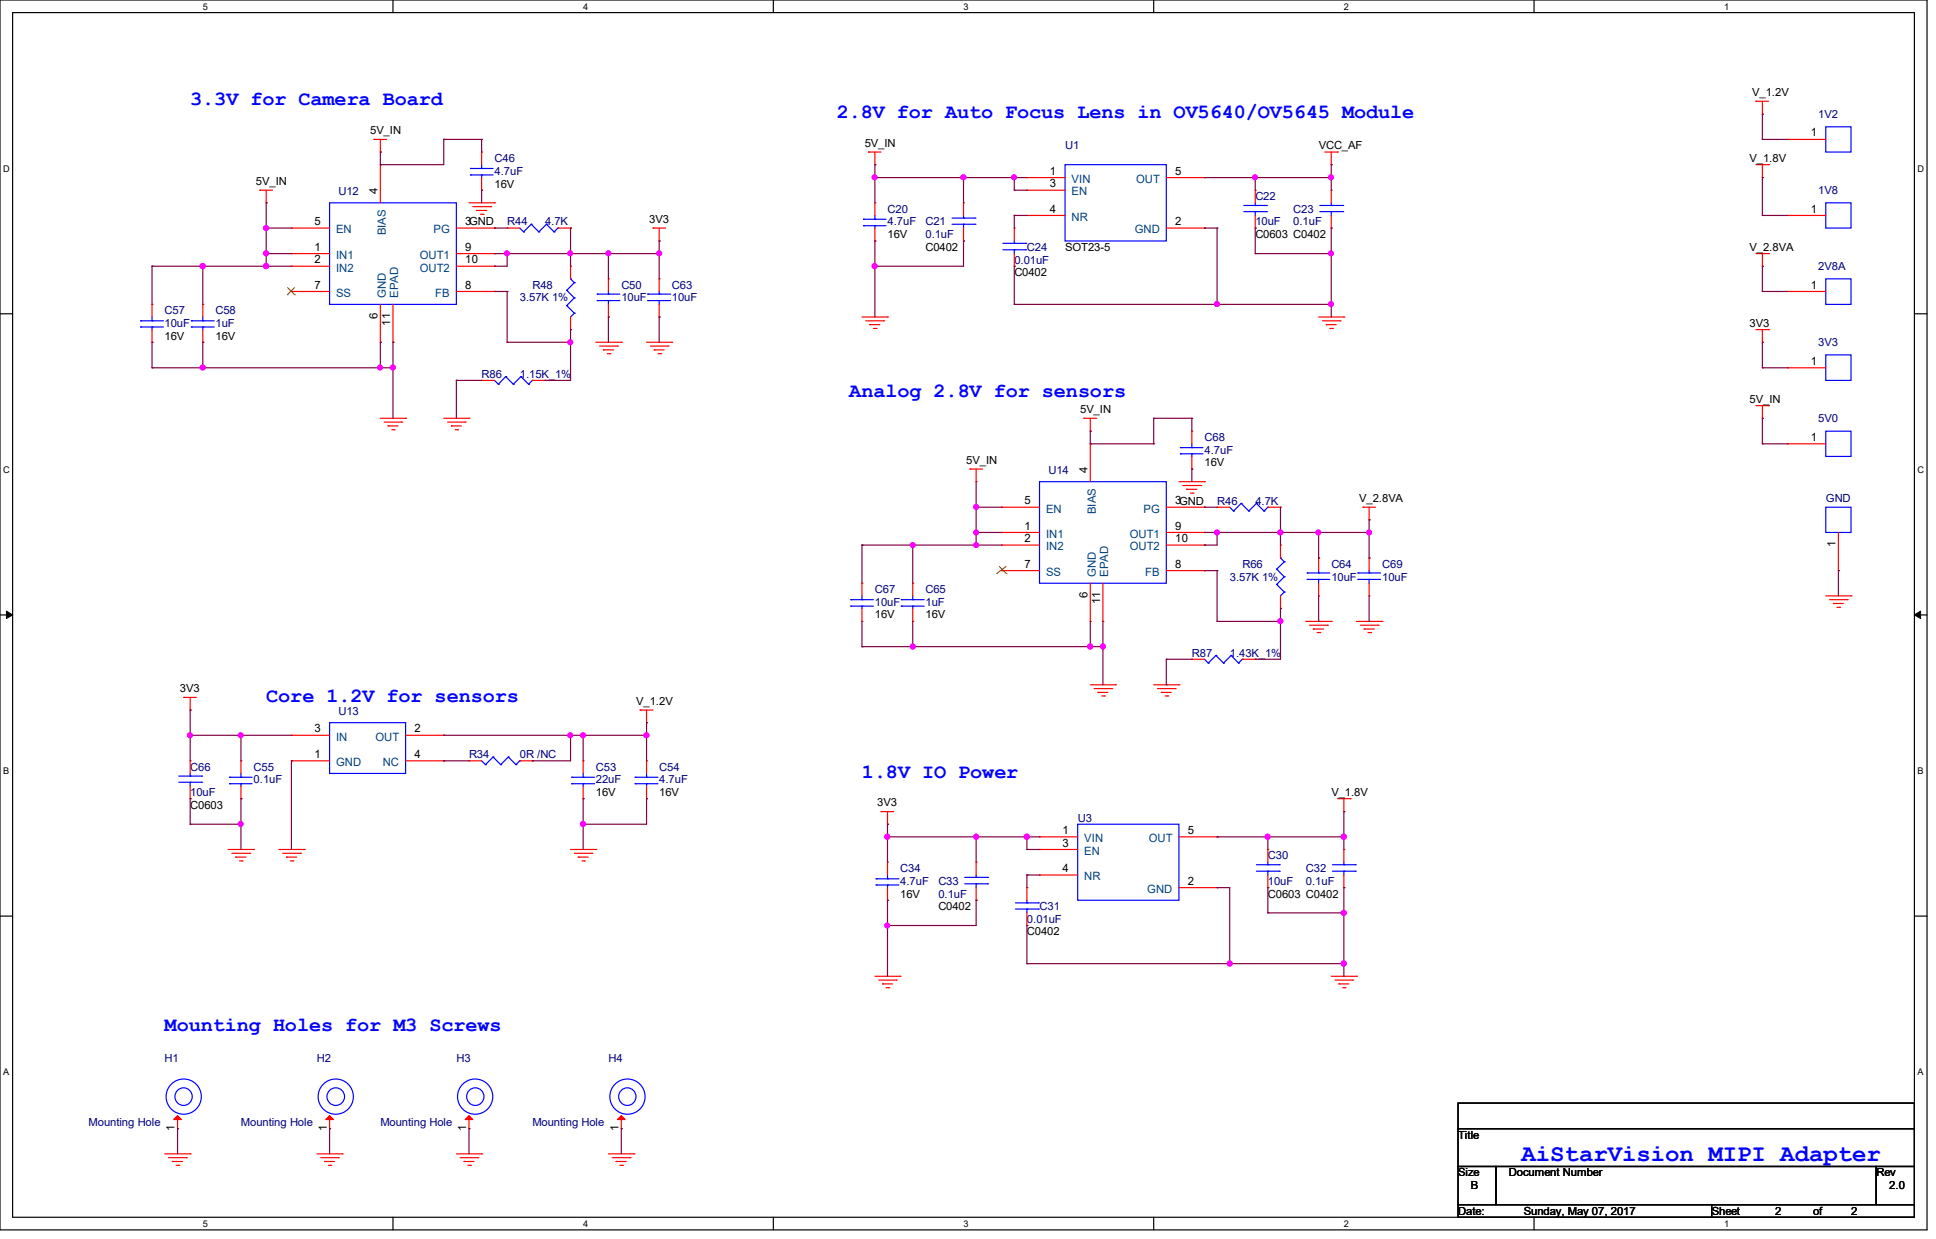
[picture p36: page 2]

Mounting Holes for M3 Screws
