Kevin-WSCU/96Boards-Camera/AISTARVISION MIPI Adapter V1.0/AiStarVsion MIPI Adapter V1.0.pdf

# To CX3 main Board

# TO OV7251 MIPI MODULE (1.8V IO Voltage)

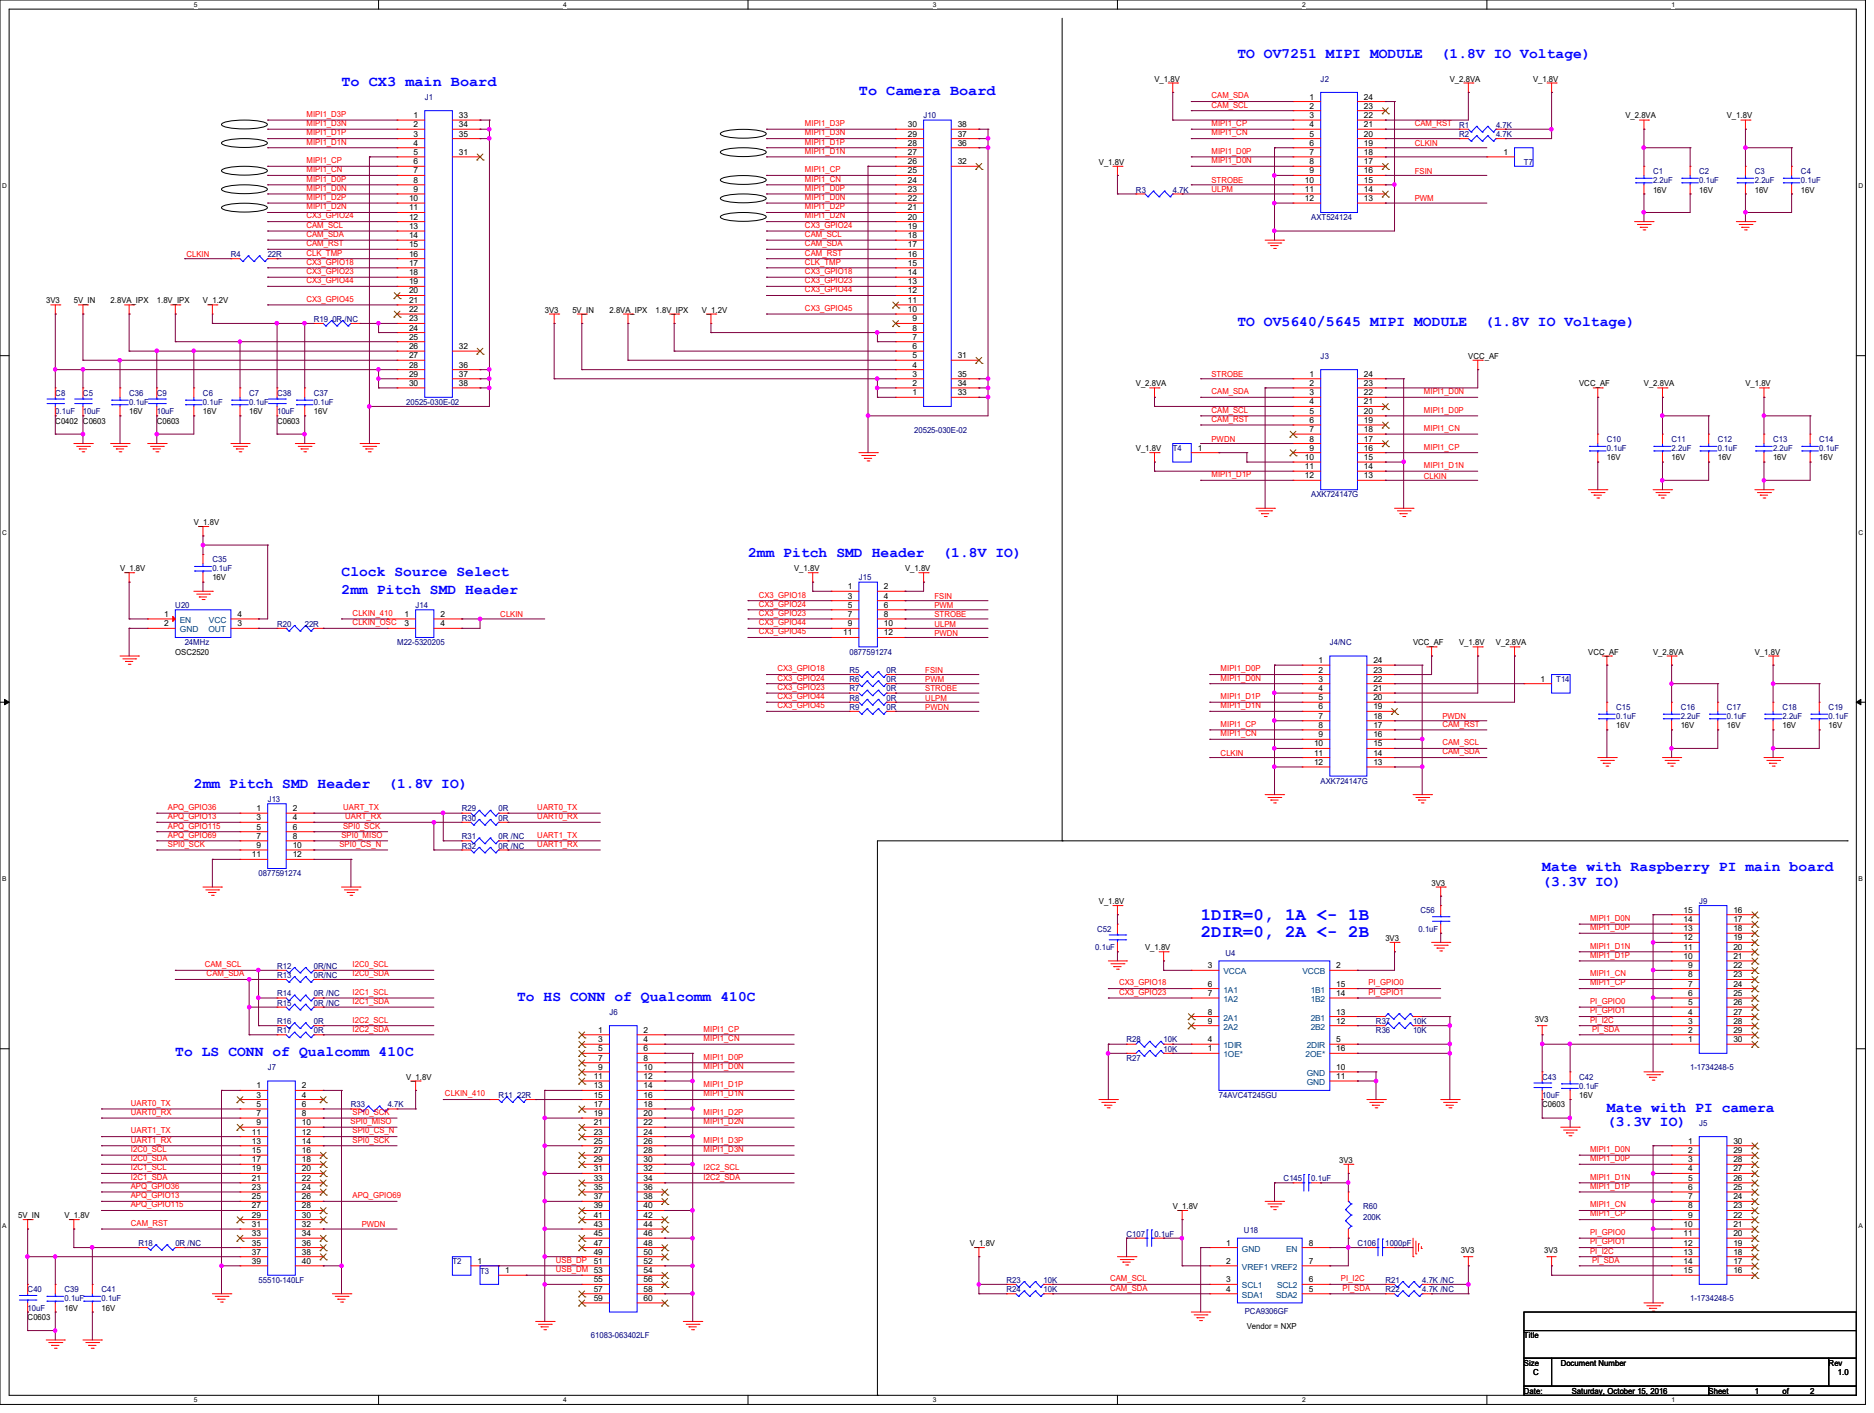
[picture p37: page 1]

2mm Pitch SMD Header (1.8V IO)

Mate with Raspberry PI main board

To HS CONN of Qualcomm 410C

To LS CONN of Qualcomm 410C

# 2.8V for Auto Focus Lens in OV5640/OV5645 Module

# 1.2V LDO MAX 1A

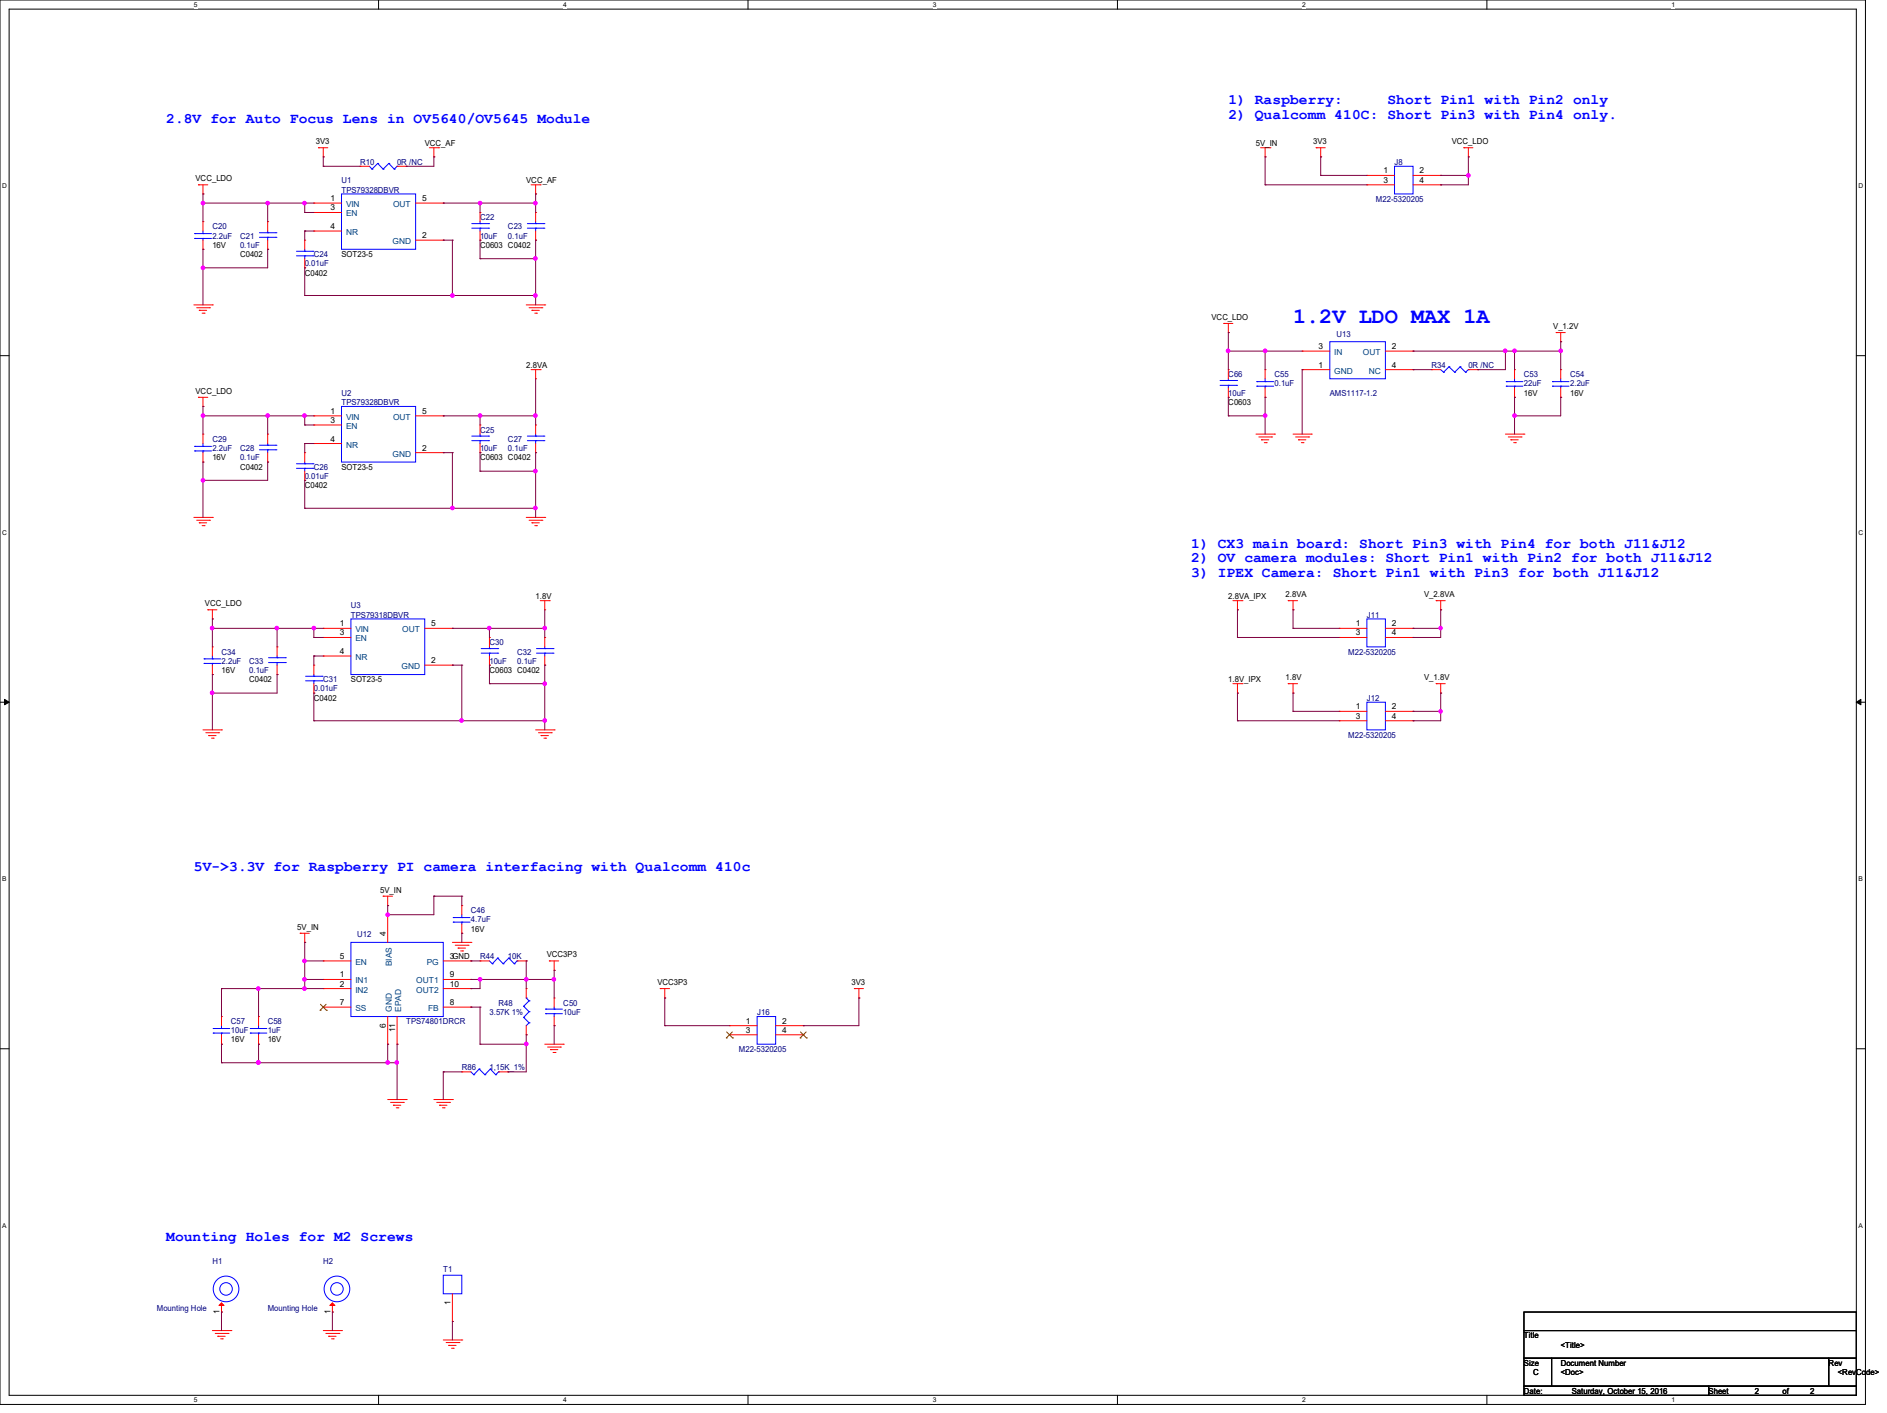
[picture p38: page 2]

2) Qualcomm 410C: Short Pin3 with Pin4 only.

1) CX3 main board: Short Pin3 with Pin4 for both J11&J12
2) OV camera modules: Short Pin1 with Pin2 for both J11&J12
3) IPEX Camera: Short Pin1 with Pin3 for both J11&J12

5V->3.3V for Raspberry PI camera interfacing with Qualcomm 410c

Mounting Holes for M2 Screws
