Kevin-WSCU/96Boards-Camera/(list of files, drawings)

Other design files:
AiStarVsion-MIPI-Adapter-V1.0/MIPI MODULE ADAPTER V1.0.DSN
