Kevin-WSCU/96Boards-Camera/OV5640-Drivers/ov5645.c

/*
 * Driver for the OV5645 camera sensor.
 *
 * Copyright (c) 2011-2015, The Linux Foundation. All rights reserved.
 * Copyright (C) 2015 By Tech Design S.L. All Rights Reserved.
 * Copyright (C) 2012-2013 Freescale Semiconductor, Inc. All Rights Reserved.
 *
 * Based on:
 * - the OV5645 driver from QC msm-3.10 kernel on codeaurora.org:
 *   https://us.codeaurora.org/cgit/quic/la/kernel/msm-3.10/tree/drivers/
 *       media/platform/msm/camera_v2/sensor/ov5645.c?h=LA.BR.1.2.4_rb1.41
 * - the OV5640 driver posted on linux-media:
 *   https://www.mail-archive.com/linux-media%40vger.kernel.org/msg92671.html
 */

/*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
 * This program is distributed in the hope that it will be useful,
 * but WITHOUT ANY WARRANTY; without even the implied warranty of
 * MERCHANTABILITY or FITNESS FOR A PARTICULAR PURPOSE.  See the
 * GNU General Public License for more details.
 */

#include <linux/bitops.h>
#include <linux/clk.h>
#include <linux/delay.h>
#include <linux/device.h>
#include <linux/gpio/consumer.h>
#include <linux/i2c.h>
#include <linux/init.h>
#include <linux/module.h>
#include <linux/of.h>
#include <linux/of_graph.h>
#include <linux/regulator/consumer.h>
#include <linux/slab.h>
#include <linux/types.h>
#include <media/v4l2-ctrls.h>
#include <media/v4l2-of.h>
#include <media/v4l2-subdev.h>

/* HACKs here! */

#include <../drivers/media/platform/msm/cci/msm_cci.h>

#ifdef dev_dbg
	#undef dev_dbg
	#define dev_dbg dev_err
#endif

#define OV5645_VOLTAGE_ANALOG               2800000
#define OV5645_VOLTAGE_DIGITAL_CORE         1500000
#define OV5645_VOLTAGE_DIGITAL_IO           1800000

#define OV5645_XCLK	23880000

#define OV5645_SYSTEM_CTRL0		0x3008
#define		OV5645_SYSTEM_CTRL0_START	0x02
#define		OV5645_SYSTEM_CTRL0_STOP	0x42
#define OV5645_CHIP_ID_HIGH_REG		0x300A
#define		OV5645_CHIP_ID_HIGH		0x56
#define OV5645_CHIP_ID_LOW_REG		0x300B
#define		OV5645_CHIP_ID_LOW		0x40
#define OV5645_AWB_MANUAL_CONTROL	0x3406
#define		OV5645_AWB_MANUAL_ENABLE	BIT(0)
#define OV5645_AEC_PK_MANUAL		0x3503
#define		OV5645_AEC_MANUAL_ENABLE	BIT(0)
#define		OV5645_AGC_MANUAL_ENABLE	BIT(1)
#define OV5645_TIMING_TC_REG20		0x3820
#define		OV5645_SENSOR_VFLIP		BIT(1)
#define		OV5645_ISP_VFLIP		BIT(2)
#define OV5645_TIMING_TC_REG21		0x3821
#define		OV5645_SENSOR_MIRROR		BIT(1)
#define OV5645_PRE_ISP_TEST_SETTING_1	0x503d
#define		OV5645_TEST_PATTERN_MASK	0x3
#define		OV5645_SET_TEST_PATTERN(x)	((x) & OV5645_TEST_PATTERN_MASK)
#define		OV5645_TEST_PATTERN_ENABLE	BIT(7)
#define OV5645_SDE_SAT_U		0x5583
#define OV5645_SDE_SAT_V		0x5584

enum ov5645_mode {
	OV5645_MODE_MIN = 0,
	OV5645_MODE_SXGA = 0,
	OV5645_MODE_1080P = 1,
	OV5645_MODE_FULL = 2,
	OV5645_MODE_MAX = 2
};

struct reg_value {
	u16 reg;
	u8 val;
};

struct ov5645_mode_info {
	enum ov5645_mode mode;
	u32 width;
	u32 height;
	struct reg_value *data;
	u32 data_size;
};

struct ov5645 {
	struct i2c_client *i2c_client;
	struct device *dev;
	struct v4l2_subdev sd;
	struct media_pad pad;
	struct v4l2_of_endpoint ep;
	struct v4l2_mbus_framefmt fmt;
	struct v4l2_rect crop;
	struct clk *xclk;

	struct regulator *io_regulator;
	struct regulator *core_regulator;
	struct regulator *analog_regulator;

	enum ov5645_mode current_mode;

	/* Cached control values */
	struct v4l2_ctrl_handler ctrls;
	struct v4l2_ctrl *saturation;
	struct v4l2_ctrl *hflip;
	struct v4l2_ctrl *vflip;
	struct v4l2_ctrl *autogain;
	struct v4l2_ctrl *autoexposure;
	struct v4l2_ctrl *awb;
	struct v4l2_ctrl *pattern;

	struct mutex power_lock; /* lock to protect power state */
	bool power;

	struct gpio_desc *enable_gpio;
	struct gpio_desc *rst_gpio;

	struct v4l2_subdev *cci;
};

static inline struct ov5645 *to_ov5645(struct v4l2_subdev *sd)
{
	return container_of(sd, struct ov5645, sd);
}
static struct reg_value OV5640_REG_1080P[] =
{
	{ 0x3103, 0x11},
	{ 0x3008, 0x82},
	{ 0x3008, 0x42},
	{ 0x3103, 0x03},
	{ 0x3017, 0x00},
	{ 0x3018, 0x00},
	{ 0x3034, 0x18},
	{ 0x3035, 0x11},
	{ 0x3036, 0x54},
	{ 0x3037, 0x13},
	{ 0x3108, 0x01},
	{ 0x3630, 0x36},
	{ 0x3631, 0x0e},
	{ 0x3632, 0xe2},
	{ 0x3633, 0x12},
	{ 0x3621, 0xe0},
	{ 0x3704, 0xa0},
	{ 0x3703, 0x5a},
	{ 0x3715, 0x78},
	{ 0x3717, 0x01},
	{ 0x370b, 0x60},
	{ 0x3705, 0x1a},
	{ 0x3905, 0x02},
	{ 0x3906, 0x10},
	{ 0x3901, 0x0a},
	{ 0x3731, 0x12},
	{ 0x3600, 0x08},
	{ 0x3601, 0x33},
	{ 0x302d, 0x60},
	{ 0x3620, 0x52},
	{ 0x371b, 0x20},
	{ 0x471c, 0x50},

        //{0x4800, 0x34},/////////////////////////free running

	{ 0x3a13, 0x43},
	{ 0x3a18, 0x00},
	{ 0x3a19, 0xf8},
	{ 0x3635, 0x13},
	{ 0x3636, 0x03},
	{ 0x3634, 0x40},
	{ 0x3622, 0x01},
	{ 0x3c01, 0x34},
	{ 0x3c04, 0x28},
	{ 0x3c05, 0x98},
	{ 0x3c06, 0x00},
	{ 0x3c07, 0x07},
	{ 0x3c08, 0x00},
	{ 0x3c09, 0x1c},
	{ 0x3c0a, 0x9c},
	{ 0x3c0b, 0x40},
	{ 0x3820, 0x40},
	{ 0x3821, 0x06},
	{ 0x3814, 0x11},
	{ 0x3815, 0x11},
	{ 0x3800, 0x01},
	{ 0x3801, 0x50},
	{ 0x3802, 0x01},
	{ 0x3803, 0xb2},
	{ 0x3804, 0x08},
	{ 0x3805, 0xef},
	{ 0x3806, 0x05},
	{ 0x3807, 0xf1},
	{ 0x3808, 0x07},
	{ 0x3809, 0x80},
	{ 0x380a, 0x04},
	{ 0x380b, 0x38},
	{ 0x380c, 0x09},//
	{ 0x380d, 0xc4},//
	{ 0x380e, 0x04},
	{ 0x380f, 0x60},
	{ 0x3810, 0x00},
	{ 0x3811, 0x10},
	{ 0x3812, 0x00},
	{ 0x3813, 0x04},
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
	{ 0x4300, 0x32},	//to match ISP UYVY
	{ 0x501f, 0x00},
	{ 0x4713, 0x02},
	{ 0x4407, 0x04},
	{ 0x440e, 0x00},
	{ 0x460b, 0x37},
	{ 0x460c, 0x20},
	{ 0x4837, 0x0a},
	{ 0x3824, 0x04},
	{ 0x5000, 0xa7},
	{ 0x5001, 0x83},
	{ 0x5180, 0xff},
	{ 0x5181, 0xf2},
	{ 0x5182, 0x00},
	{ 0x5183, 0x14},
	{ 0x5184, 0x25},
	{ 0x5185, 0x24},
	{ 0x5186, 0x09},
	{ 0x5187, 0x09},
	{ 0x5188, 0x09},
	{ 0x5189, 0x75},
	{ 0x518a, 0x54},
	{ 0x518b, 0xe0},
	{ 0x518c, 0xb2},
	{ 0x518d, 0x42},
	{ 0x518e, 0x3d},
	{ 0x518f, 0x56},
	{ 0x5190, 0x46},
	{ 0x5191, 0xf8},
	{ 0x5192, 0x04},
	{ 0x5193, 0x70},
	{ 0x5194, 0xf0},
	{ 0x5195, 0xf0},
	{ 0x5196, 0x03},
	{ 0x5197, 0x01},
	{ 0x5198, 0x04},
	{ 0x5199, 0x12},
	{ 0x519a, 0x04},
	{ 0x519b, 0x00},
	{ 0x519c, 0x06},
	{ 0x519d, 0x82},
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

};

static struct reg_value ov5645_global_init_setting[] = {
	{ 0x3103, 0x11 },
	{ 0x3008, 0x82 },
	{ 0x3008, 0x42 },
	{ 0x3103, 0x03 },
	{ 0x3503, 0x07 },
	{ 0x3002, 0x1c },
	{ 0x3006, 0xc3 },
	{ 0x300e, 0x45 },
	{ 0x3017, 0x00 },
	{ 0x3018, 0x00 },
	{ 0x302e, 0x0b },
	{ 0x3037, 0x13 },
	{ 0x3108, 0x01 },
	{ 0x3611, 0x06 },
	{ 0x3500, 0x00 },
	{ 0x3501, 0x01 },
	{ 0x3502, 0x00 },
	{ 0x350a, 0x00 },
	{ 0x350b, 0x3f },
	{ 0x3620, 0x33 },
	{ 0x3621, 0xe0 },
	{ 0x3622, 0x01 },
	{ 0x3630, 0x2e },
	{ 0x3631, 0x00 },
	{ 0x3632, 0x32 },
	{ 0x3633, 0x52 },
	{ 0x3634, 0x70 },
	{ 0x3635, 0x13 },
	{ 0x3636, 0x03 },
	{ 0x3703, 0x5a },
	{ 0x3704, 0xa0 },
	{ 0x3705, 0x1a },
	{ 0x3709, 0x12 },
	{ 0x370b, 0x61 },
	{ 0x370f, 0x10 },
	{ 0x3715, 0x78 },
	{ 0x3717, 0x01 },
	{ 0x371b, 0x20 },
	{ 0x3731, 0x12 },
	{ 0x3901, 0x0a },
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
};

static struct reg_value ov5645_setting_sxga[] = {
	{ 0x3612, 0xa9 },
	{ 0x3614, 0x50 },
	{ 0x3618, 0x00 },
	{ 0x3034, 0x18 },
	{ 0x3035, 0x21 },
	{ 0x3036, 0x70 },
	{ 0x3600, 0x09 },
	{ 0x3601, 0x43 },
	{ 0x3708, 0x66 },
	{ 0x370c, 0xc3 },
	{ 0x3800, 0x00 },
	{ 0x3801, 0x00 },
	{ 0x3802, 0x00 },
	{ 0x3803, 0x06 },
	{ 0x3804, 0x0a },
	{ 0x3805, 0x3f },
	{ 0x3806, 0x07 },
	{ 0x3807, 0x9d },
	{ 0x3808, 0x05 },
	{ 0x3809, 0x00 },
	{ 0x380a, 0x03 },
	{ 0x380b, 0xc0 },
	{ 0x380c, 0x07 },
	{ 0x380d, 0x68 },
	{ 0x380e, 0x03 },
	{ 0x380f, 0xd8 },
	{ 0x3813, 0x06 },
	{ 0x3814, 0x31 },
	{ 0x3815, 0x31 },
	{ 0x3820, 0x47 },
	{ 0x3a02, 0x03 },
	{ 0x3a03, 0xd8 },
	{ 0x3a08, 0x01 },
	{ 0x3a09, 0xf8 },
	{ 0x3a0a, 0x01 },
	{ 0x3a0b, 0xa4 },
	{ 0x3a0e, 0x02 },
	{ 0x3a0d, 0x02 },
	{ 0x3a14, 0x03 },
	{ 0x3a15, 0xd8 },
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
};

static struct reg_value ov5645_setting_1080p[] = {
	{ 0x3612, 0xab },
	{ 0x3614, 0x50 },
	{ 0x3618, 0x04 },
	{ 0x3034, 0x18 },
	{ 0x3035, 0x11 },
	{ 0x3036, 0x54 },
	{ 0x3600, 0x08 },
	{ 0x3601, 0x33 },
	{ 0x3708, 0x63 },
	{ 0x370c, 0xc0 },
	{ 0x3800, 0x01 },
	{ 0x3801, 0x50 },
	{ 0x3802, 0x01 },
	{ 0x3803, 0xb2 },
	{ 0x3804, 0x08 },
	{ 0x3805, 0xef },
	{ 0x3806, 0x05 },
	{ 0x3807, 0xf1 },
	{ 0x3808, 0x07 },
	{ 0x3809, 0x80 },
	{ 0x380a, 0x04 },
	{ 0x380b, 0x38 },
	{ 0x380c, 0x09 },
	{ 0x380d, 0xc4 },
	{ 0x380e, 0x04 },
	{ 0x380f, 0x60 },
	{ 0x3813, 0x04 },
	{ 0x3814, 0x11 },
	{ 0x3815, 0x11 },
	{ 0x3820, 0x47 },
	{ 0x4514, 0x88 },
	{ 0x3a02, 0x04 },
	{ 0x3a03, 0x60 },
	{ 0x3a08, 0x01 },
	{ 0x3a09, 0x50 },
	{ 0x3a0a, 0x01 },
	{ 0x3a0b, 0x18 },
	{ 0x3a0e, 0x03 },
	{ 0x3a0d, 0x04 },
	{ 0x3a14, 0x04 },
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
};

static struct reg_value ov5645_setting_full[] = {
	{ 0x3612, 0xab },
	{ 0x3614, 0x50 },
	{ 0x3618, 0x04 },
	{ 0x3034, 0x18 },
	{ 0x3035, 0x11 },
	{ 0x3036, 0x54 },
	{ 0x3600, 0x08 },
	{ 0x3601, 0x33 },
	{ 0x3708, 0x63 },
	{ 0x370c, 0xc0 },
	{ 0x3800, 0x00 },
	{ 0x3801, 0x00 },
	{ 0x3802, 0x00 },
	{ 0x3803, 0x00 },
	{ 0x3804, 0x0a },
	{ 0x3805, 0x3f },
	{ 0x3806, 0x07 },
	{ 0x3807, 0x9f },
	{ 0x3808, 0x0a },
	{ 0x3809, 0x20 },
	{ 0x380a, 0x07 },
	{ 0x380b, 0x98 },
	{ 0x380c, 0x0b },
	{ 0x380d, 0x1c },
	{ 0x380e, 0x07 },
	{ 0x380f, 0xb0 },
	{ 0x3813, 0x06 },
	{ 0x3814, 0x11 },
	{ 0x3815, 0x11 },
	{ 0x3820, 0x47 },
	{ 0x4514, 0x88 },
	{ 0x3a02, 0x07 },
	{ 0x3a03, 0xb0 },
	{ 0x3a08, 0x01 },
	{ 0x3a09, 0x27 },
	{ 0x3a0a, 0x00 },
	{ 0x3a0b, 0xf6 },
	{ 0x3a0e, 0x06 },
	{ 0x3a0d, 0x08 },
	{ 0x3a14, 0x07 },
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
};

static struct ov5645_mode_info ov5645_mode_info_data[OV5645_MODE_MAX + 1] = {
	{
		.mode = OV5645_MODE_SXGA,
		.width = 1280,
		.height = 960,
		.data = ov5645_setting_sxga,
		.data_size = ARRAY_SIZE(ov5645_setting_sxga)
	},
	{
		.mode = OV5645_MODE_1080P,
		.width = 1920,
		.height = 1080,
		.data = ov5645_setting_1080p,
		.data_size = ARRAY_SIZE(ov5645_setting_1080p)
	},
	{
		.mode = OV5645_MODE_FULL,
		.width = 2592,
		.height = 1944,
		.data = ov5645_setting_full,
		.data_size = ARRAY_SIZE(ov5645_setting_full)
	},
};

static int ov5645_regulators_enable(struct ov5645 *ov5645)
{
	int ret;

	ret = regulator_enable(ov5645->io_regulator);
	if (ret < 0) {
		dev_err(ov5645->dev, "set io voltage failed\n");
		goto exit;
	}

	ret = regulator_enable(ov5645->core_regulator);
	if (ret) {
		dev_err(ov5645->dev, "set core voltage failed\n");
		goto err_disable_io;
	}

	ret = regulator_enable(ov5645->analog_regulator);
	if (ret) {
		dev_err(ov5645->dev, "set analog voltage failed\n");
		goto err_disable_core;
	}

	return 0;

err_disable_core:
	regulator_disable(ov5645->core_regulator);
err_disable_io:
	regulator_disable(ov5645->io_regulator);
exit:
	return ret;
}

static void ov5645_regulators_disable(struct ov5645 *ov5645)
{
	int ret;

	ret = regulator_disable(ov5645->analog_regulator);
	if (ret < 0)
		dev_err(ov5645->dev, "analog regulator disable failed\n");

	ret = regulator_disable(ov5645->core_regulator);
	if (ret < 0)
		dev_err(ov5645->dev, "core regulator disable failed\n");

	ret = regulator_disable(ov5645->io_regulator);
	if (ret < 0)
		dev_err(ov5645->dev, "io regulator disable failed\n");
}

static int ov5645_write_reg(struct ov5645 *ov5645, u16 reg, u8 val)
{
	int ret;

	ret = msm_cci_ctrl_write(reg, &val, 1);
	if (ret < 0)
		dev_err(ov5645->dev, "%s: write reg error %d: reg=%x, val=%x\n",
			__func__, ret, reg, val);

	return ret;
}

static int ov5645_read_reg(struct ov5645 *ov5645, u16 reg, u8 *val)
{
	u8 tmpval;
	int ret;

	ret = msm_cci_ctrl_read(reg, &tmpval, 1);
	if (ret < 0) {
		dev_err(ov5645->dev, "%s: read reg error %d: reg=%x\n",
			__func__, ret, reg);
		return ret;
	}

	*val = tmpval;

	return 0;
}

static int ov5645_set_aec_mode(struct ov5645 *ov5645, u32 mode)
{
	u8 val;
	int ret;

	ret = ov5645_read_reg(ov5645, OV5645_AEC_PK_MANUAL, &val);
	if (ret < 0)
		return ret;

	if (mode == V4L2_EXPOSURE_AUTO)
		val &= ~OV5645_AEC_MANUAL_ENABLE;
	else /* V4L2_EXPOSURE_MANUAL */
		val |= OV5645_AEC_MANUAL_ENABLE;

	dev_dbg(ov5645->dev, "%s: mode = %d\n", __func__, mode);

	return ov5645_write_reg(ov5645, OV5645_AEC_PK_MANUAL, val);
}

static int ov5645_set_agc_mode(struct ov5645 *ov5645, u32 enable)
{
	u8 val;
	int ret;

	ret = ov5645_read_reg(ov5645, OV5645_AEC_PK_MANUAL, &val);
	if (ret < 0)
		return ret;

	if (enable)
		val &= ~OV5645_AGC_MANUAL_ENABLE;
	else
		val |= OV5645_AGC_MANUAL_ENABLE;

	dev_dbg(ov5645->dev, "%s: enable = %d\n", __func__, enable);

	return ov5645_write_reg(ov5645, OV5645_AEC_PK_MANUAL, val);
}

static int ov5645_set_register_array(struct ov5645 *ov5645,
				     struct reg_value *settings,
				     u32 num_settings)
{
	u16 reg;
	u8 val;
	u32 i;
	int ret = 0;

	for (i = 0; i < num_settings; ++i, ++settings) {
		reg = settings->reg;
		val = settings->val;

		ret = ov5645_write_reg(ov5645, reg, val);
		if (ret < 0)
			goto err;
	}
err:
	return ret;
}

static int ov5645_init(struct ov5645 *ov5645)
{
	struct reg_value *settings;
	u32 num_settings;

	settings = OV5640_REG_1080P;
	num_settings = ARRAY_SIZE(OV5640_REG_1080P);

	return ov5645_set_register_array(ov5645, settings, num_settings);
}

static int ov5645_change_mode(struct ov5645 *ov5645, enum ov5645_mode mode)
{
	struct reg_value *settings;
	u32 num_settings;

	settings = ov5645_mode_info_data[mode].data;
	num_settings = ov5645_mode_info_data[mode].data_size;

	return ov5645_set_register_array(ov5645, settings, num_settings);
}

static int ov5645_set_power_on(struct ov5645 *ov5645)
{
	int ret;

	dev_dbg(ov5645->dev, "%s: Vistar Enter\n", __func__);

	clk_set_rate(ov5645->xclk, OV5645_XCLK);

	ret = clk_prepare_enable(ov5645->xclk);
	if (ret < 0) {
		dev_err(ov5645->dev, "clk prepare enable failed\n");
		return ret;
	}

	ret = ov5645_regulators_enable(ov5645);
	if (ret < 0) {
		clk_disable_unprepare(ov5645->xclk);
		return ret;
	}

// Not sure the circuit on STM sensor board,the default kernel gpio operation will do :
//1)Reset:High
//2)PWDN:Low
	usleep_range(1000, 2000);
	gpiod_set_value_cansleep(ov5645->rst_gpio, 0);

	usleep_range(5000, 15000);
	gpiod_set_value_cansleep(ov5645->enable_gpio, 0);
	
	msleep(20);

	return ret;
}

static void ov5645_set_power_off(struct ov5645 *ov5645)
{
	dev_dbg(ov5645->dev, "%s: Vistar Enter\n", __func__);


	if (ov5645->rst_gpio)
		gpiod_set_value_cansleep(ov5645->rst_gpio, 1);
	if (ov5645->enable_gpio)
		gpiod_set_value_cansleep(ov5645->enable_gpio, 1);

	ov5645_regulators_disable(ov5645);
	clk_disable_unprepare(ov5645->xclk);
}

static int ov5645_s_power(struct v4l2_subdev *sd, int on)
{
	struct ov5645 *ov5645 = to_ov5645(sd);
	int ret = 0;

	dev_dbg(ov5645->dev, "%s: on = %d\n", __func__, on);

	mutex_lock(&ov5645->power_lock);

	if (on) {
		ret = msm_cci_ctrl_init();
		if (ret < 0)
			goto exit;
	}

	if (ov5645->power == !on) {
		/* Power state changes. */
		if (on) {
			ret = ov5645_set_power_on(ov5645);
			if (ret < 0) {
				dev_err(ov5645->dev, "could not set power %s\n",
					on ? "on" : "off");
				goto exit;
			}

			ret = ov5645_init(ov5645);
			if (ret < 0) {
				dev_err(ov5645->dev,
					"could not set init registers\n");
				ov5645_set_power_off(ov5645);
				goto exit;
			}

			ret = ov5645_write_reg(ov5645, OV5645_SYSTEM_CTRL0,
					       OV5645_SYSTEM_CTRL0_STOP);
			if (ret < 0) {
				ov5645_set_power_off(ov5645);
				goto exit;
			}
		} else {
			ov5645_set_power_off(ov5645);
		}

		/* Update the power state. */
		ov5645->power = on ? true : false;
	}

exit:
	if (!on)
		msm_cci_ctrl_release();

	mutex_unlock(&ov5645->power_lock);

	return ret;
}


static int ov5645_set_saturation(struct ov5645 *ov5645, s32 value)
{
	u32 reg_value = (value * 0x10) + 0x40;
	int ret = 0;

	ret |= ov5645_write_reg(ov5645, OV5645_SDE_SAT_U, reg_value);
	ret |= ov5645_write_reg(ov5645, OV5645_SDE_SAT_V, reg_value);

	dev_dbg(ov5645->dev, "%s: value = %d\n", __func__, value);

	return ret;
}

static int ov5645_set_hflip(struct ov5645 *ov5645, s32 value)
{
	u8 val;
	int ret;

	ret = ov5645_read_reg(ov5645, OV5645_TIMING_TC_REG21, &val);
	if (ret < 0)
		return ret;

	if (value == 0)
		val &= ~(OV5645_SENSOR_MIRROR);
	else
		val |= (OV5645_SENSOR_MIRROR);

	dev_dbg(ov5645->dev, "%s: value = %d\n", __func__, value);

	return ov5645_write_reg(ov5645, OV5645_TIMING_TC_REG21, val);
}

static int ov5645_set_vflip(struct ov5645 *ov5645, s32 value)
{
	u8 val;
	int ret;

	ret = ov5645_read_reg(ov5645, OV5645_TIMING_TC_REG20, &val);
	if (ret < 0)
		return ret;

	if (value == 0)
		val |= (OV5645_SENSOR_VFLIP | OV5645_ISP_VFLIP);
	else
		val &= ~(OV5645_SENSOR_VFLIP | OV5645_ISP_VFLIP);

	dev_dbg(ov5645->dev, "%s: value = %d\n", __func__, value);

	return ov5645_write_reg(ov5645, OV5645_TIMING_TC_REG20, val);
}

static int ov5645_set_test_pattern(struct ov5645 *ov5645, s32 value)
{
	u8 val;
	int ret;

	ret = ov5645_read_reg(ov5645, OV5645_PRE_ISP_TEST_SETTING_1, &val);
	if (ret < 0)
		return ret;

	if (value) {
		val &= ~OV5645_SET_TEST_PATTERN(OV5645_TEST_PATTERN_MASK);
		val |= OV5645_SET_TEST_PATTERN(value - 1);
		val |= OV5645_TEST_PATTERN_ENABLE;
	} else {
		val &= ~OV5645_TEST_PATTERN_ENABLE;
	}

	dev_dbg(ov5645->dev, "%s: value = %d\n", __func__, value);

	return ov5645_write_reg(ov5645, OV5645_PRE_ISP_TEST_SETTING_1, val);
}

static const char * const ov5645_test_pattern_menu[] = {
	"Disabled",
	"Vertical Color Bars",
	"Random Data",
	"Color Square",
	"Black Image",
};

static int ov5645_set_awb(struct ov5645 *ov5645, s32 enable_auto)
{
	u8 val;
	int ret;

	ret = ov5645_read_reg(ov5645, OV5645_AWB_MANUAL_CONTROL, &val);
	if (ret < 0)
		return ret;

	if (enable_auto)
		val &= ~OV5645_AWB_MANUAL_ENABLE;
	else
		val |= OV5645_AWB_MANUAL_ENABLE;

	dev_dbg(ov5645->dev, "%s: enable_auto = %d\n", __func__, enable_auto);

	return ov5645_write_reg(ov5645, OV5645_AWB_MANUAL_CONTROL, val);
}

static int ov5645_s_ctrl(struct v4l2_ctrl *ctrl)
{
	struct ov5645 *ov5645 = container_of(ctrl->handler,
					     struct ov5645, ctrls);
	int ret = -EINVAL;

	mutex_lock(&ov5645->power_lock);
	if (ov5645->power == 0) {
		mutex_unlock(&ov5645->power_lock);
		return 0;
	}

	switch (ctrl->id) {
	case V4L2_CID_SATURATION:
		ret = ov5645_set_saturation(ov5645, ctrl->val);
		break;
	case V4L2_CID_AUTO_WHITE_BALANCE:
		ret = ov5645_set_awb(ov5645, ctrl->val);
		break;
	case V4L2_CID_AUTOGAIN:
		ret = ov5645_set_agc_mode(ov5645, ctrl->val);
		break;
	case V4L2_CID_EXPOSURE_AUTO:
		ret = ov5645_set_aec_mode(ov5645, ctrl->val);
		break;
	case V4L2_CID_TEST_PATTERN:
		ret = ov5645_set_test_pattern(ov5645, ctrl->val);
		break;
	case V4L2_CID_HFLIP:
		ret = ov5645_set_hflip(ov5645, ctrl->val);
		break;
	case V4L2_CID_VFLIP:
		ret = ov5645_set_vflip(ov5645, ctrl->val);
		break;
	}

	mutex_unlock(&ov5645->power_lock);

	return ret;
}

static struct v4l2_ctrl_ops ov5645_ctrl_ops = {
	.s_ctrl = ov5645_s_ctrl,
};

static int ov5645_enum_mbus_code(struct v4l2_subdev *sd,
				 struct v4l2_subdev_pad_config *cfg,
				 struct v4l2_subdev_mbus_code_enum *code)
{
	struct ov5645 *ov5645 = to_ov5645(sd);

	if (code->index > 0)
		return -EINVAL;

	code->code = ov5645->fmt.code;

	return 0;
}

static int ov5645_enum_frame_size(struct v4l2_subdev *subdev,
				  struct v4l2_subdev_pad_config *cfg,
				  struct v4l2_subdev_frame_size_enum *fse)
{
	if (fse->index >= OV5645_MODE_MAX)
		return -EINVAL;

	fse->min_width = ov5645_mode_info_data[fse->index].width;
	fse->max_width = ov5645_mode_info_data[fse->index].width;
	fse->min_height = ov5645_mode_info_data[fse->index].height;
	fse->max_height = ov5645_mode_info_data[fse->index].height;

	return 0;
}

static struct v4l2_mbus_framefmt *
__ov5645_get_pad_format(struct ov5645 *ov5645,
			struct v4l2_subdev_pad_config *cfg,
			unsigned int pad,
			enum v4l2_subdev_format_whence which)
{
	switch (which) {
	case V4L2_SUBDEV_FORMAT_TRY:
		return v4l2_subdev_get_try_format(&ov5645->sd, cfg, pad);
	case V4L2_SUBDEV_FORMAT_ACTIVE:
		return &ov5645->fmt;
	default:
		return NULL;
	}
}

static int ov5645_get_format(struct v4l2_subdev *sd,
			     struct v4l2_subdev_pad_config *cfg,
			     struct v4l2_subdev_format *format)
{
	struct ov5645 *ov5645 = to_ov5645(sd);

	format->format = *__ov5645_get_pad_format(ov5645, cfg, format->pad,
						  format->which);
	return 0;
}

static struct v4l2_rect *
__ov5645_get_pad_crop(struct ov5645 *ov5645, struct v4l2_subdev_pad_config *cfg,
		      unsigned int pad, enum v4l2_subdev_format_whence which)
{
	switch (which) {
	case V4L2_SUBDEV_FORMAT_TRY:
		return v4l2_subdev_get_try_crop(&ov5645->sd, cfg, pad);
	case V4L2_SUBDEV_FORMAT_ACTIVE:
		return &ov5645->crop;
	default:
		return NULL;
	}
}

static enum ov5645_mode ov5645_find_nearest_mode(struct ov5645 *ov5645,
						 int width, int height)
{
	int i;

	for (i = OV5645_MODE_MAX; i >= 0; i--) {
		if (ov5645_mode_info_data[i].width <= width &&
		    ov5645_mode_info_data[i].height <= height)
			break;
	}

	if (i < 0)
		i = 0;

	return (enum ov5645_mode)i;
}

static int ov5645_set_format(struct v4l2_subdev *sd,
			     struct v4l2_subdev_pad_config *cfg,
			     struct v4l2_subdev_format *format)
{
	struct ov5645 *ov5645 = to_ov5645(sd);
	struct v4l2_mbus_framefmt *__format;
	struct v4l2_rect *__crop;
	enum ov5645_mode new_mode;

	__crop = __ov5645_get_pad_crop(ov5645, cfg, format->pad,
			format->which);

	new_mode = ov5645_find_nearest_mode(ov5645,
			format->format.width, format->format.height);
	__crop->width = ov5645_mode_info_data[new_mode].width;
	__crop->height = ov5645_mode_info_data[new_mode].height;

	ov5645->current_mode = new_mode;

	__format = __ov5645_get_pad_format(ov5645, cfg, format->pad,
			format->which);
	__format->width = __crop->width;
	__format->height = __crop->height;

	return 0;
}

static int ov5645_get_selection(struct v4l2_subdev *sd,
			   struct v4l2_subdev_pad_config *cfg,
			   struct v4l2_subdev_selection *sel)
{
	struct ov5645 *ov5645 = to_ov5645(sd);

	if (sel->target != V4L2_SEL_TGT_CROP)
		return -EINVAL;

	sel->r = *__ov5645_get_pad_crop(ov5645, cfg, sel->pad,
					sel->which);
	return 0;
}

static int ov5645_s_stream(struct v4l2_subdev *subdev, int enable)
{
	struct ov5645 *ov5645 = to_ov5645(subdev);
	int ret;

	dev_dbg(ov5645->dev, "%s: enable = %d\n", __func__, enable);

	if (enable) {
		/*
		ret = ov5645_change_mode(ov5645, ov5645->current_mode);
		if (ret < 0) {
			dev_err(ov5645->dev, "could not set mode %d\n",
				ov5645->current_mode);
			return ret;
		}
		
		ret = v4l2_ctrl_handler_setup(&ov5645->ctrls);
		if (ret < 0) {
			dev_err(ov5645->dev, "could not sync v4l2 controls\n");
			return ret;
		}
		*/
		ret = ov5645_write_reg(ov5645, OV5645_SYSTEM_CTRL0,
				       OV5645_SYSTEM_CTRL0_START);
		if (ret < 0)
			return ret;
	} else {
		ret = ov5645_write_reg(ov5645, OV5645_SYSTEM_CTRL0,
				       OV5645_SYSTEM_CTRL0_STOP);
		if (ret < 0)
			return ret;
	}

	return 0;
}

static struct v4l2_subdev_core_ops ov5645_core_ops = {
	.s_power = ov5645_s_power,
};

static struct v4l2_subdev_video_ops ov5645_video_ops = {
	.s_stream = ov5645_s_stream,
};

static struct v4l2_subdev_pad_ops ov5645_subdev_pad_ops = {
	.enum_mbus_code = ov5645_enum_mbus_code,
	.enum_frame_size = ov5645_enum_frame_size,
	.get_fmt = ov5645_get_format,
	.set_fmt = ov5645_set_format,
	.get_selection = ov5645_get_selection,
};

static struct v4l2_subdev_ops ov5645_subdev_ops = {
	.core = &ov5645_core_ops,
	.video = &ov5645_video_ops,
	.pad = &ov5645_subdev_pad_ops,
};

static const struct v4l2_subdev_internal_ops ov5645_subdev_internal_ops = {
};

static int ov5645_probe(struct i2c_client *client,
			const struct i2c_device_id *id)
{
	struct device *dev = &client->dev;
	struct device_node *endpoint;
	struct ov5645 *ov5645;
	u8 chip_id_high, chip_id_low;
	int ret;

	ov5645 = devm_kzalloc(dev, sizeof(struct ov5645), GFP_KERNEL);
	if (!ov5645)
		return -ENOMEM;

	ov5645->i2c_client = client;
	ov5645->dev = dev;
	ov5645->fmt.code = MEDIA_BUS_FMT_UYVY8_2X8;
	ov5645->fmt.width = 1920;
	ov5645->fmt.height = 1080;
	ov5645->fmt.field = V4L2_FIELD_NONE;
	ov5645->fmt.colorspace = V4L2_COLORSPACE_SRGB;
	ov5645->current_mode = OV5645_MODE_1080P;

	endpoint = of_graph_get_next_endpoint(dev->of_node, NULL);
	if (!endpoint) {
		dev_err(dev, "endpoint node not found\n");
		return -EINVAL;
	}

	ret = v4l2_of_parse_endpoint(endpoint, &ov5645->ep);
	if (ret < 0) {
		dev_err(dev, "parsing endpoint node failed\n");
		return ret;
	}
	if (ov5645->ep.bus_type != V4L2_MBUS_CSI2) {
		dev_err(dev, "invalid bus type, must be CSI2\n");
		of_node_put(endpoint);
		return -EINVAL;
	}
	of_node_put(endpoint);

	/* get system clock (xclk) */
	ov5645->xclk = devm_clk_get(dev, "xclk");
	if (IS_ERR(ov5645->xclk)) {
		dev_err(dev, "could not get xclk");
		return PTR_ERR(ov5645->xclk);
	}

	ov5645->io_regulator = devm_regulator_get(dev, "vdddo");
	if (IS_ERR(ov5645->io_regulator)) {
		dev_err(dev, "cannot get io regulator\n");
		return PTR_ERR(ov5645->io_regulator);
	}

	ret = regulator_set_voltage(ov5645->io_regulator,
				    OV5645_VOLTAGE_DIGITAL_IO,
				    OV5645_VOLTAGE_DIGITAL_IO);
	if (ret < 0) {
		dev_err(dev, "cannot set io voltage\n");
		return ret;
	}

	ov5645->core_regulator = devm_regulator_get(dev, "vddd");
	if (IS_ERR(ov5645->core_regulator)) {
		dev_err(dev, "cannot get core regulator\n");
		return PTR_ERR(ov5645->core_regulator);
	}

	ret = regulator_set_voltage(ov5645->core_regulator,
				    OV5645_VOLTAGE_DIGITAL_CORE,
				    OV5645_VOLTAGE_DIGITAL_CORE);
	if (ret < 0) {
		dev_err(dev, "cannot set core voltage\n");
		return ret;
	}

	ov5645->analog_regulator = devm_regulator_get(dev, "vdda");
	if (IS_ERR(ov5645->analog_regulator)) {
		dev_err(dev, "cannot get analog regulator\n");
		return PTR_ERR(ov5645->analog_regulator);
	}

	ret = regulator_set_voltage(ov5645->analog_regulator,
				    OV5645_VOLTAGE_ANALOG,
				    OV5645_VOLTAGE_ANALOG);
	if (ret < 0) {
		dev_err(dev, "cannot set analog voltage\n");
		return ret;
	}

	ov5645->enable_gpio = devm_gpiod_get(dev, "enable", GPIOD_OUT_HIGH);
	if (IS_ERR(ov5645->enable_gpio)) {
		dev_err(dev, "cannot get enable gpio\n");
		return PTR_ERR(ov5645->enable_gpio);
	}

	ov5645->rst_gpio = devm_gpiod_get(dev, "reset", GPIOD_OUT_HIGH);
	if (IS_ERR(ov5645->rst_gpio)) {
		dev_err(dev, "cannot get reset gpio\n");
		return PTR_ERR(ov5645->rst_gpio);
	}

	mutex_init(&ov5645->power_lock);

	v4l2_ctrl_handler_init(&ov5645->ctrls, 7);
	ov5645->saturation = v4l2_ctrl_new_std(&ov5645->ctrls, &ov5645_ctrl_ops,
				V4L2_CID_SATURATION, -4, 4, 1, 0);
	ov5645->hflip = v4l2_ctrl_new_std(&ov5645->ctrls, &ov5645_ctrl_ops,
				V4L2_CID_HFLIP, 0, 1, 1, 0);
	ov5645->vflip = v4l2_ctrl_new_std(&ov5645->ctrls, &ov5645_ctrl_ops,
				V4L2_CID_VFLIP, 0, 1, 1, 0);
	ov5645->autogain = v4l2_ctrl_new_std(&ov5645->ctrls, &ov5645_ctrl_ops,
				V4L2_CID_AUTOGAIN, 0, 1, 1, 1);
	ov5645->autoexposure = v4l2_ctrl_new_std_menu(&ov5645->ctrls,
				&ov5645_ctrl_ops, V4L2_CID_EXPOSURE_AUTO,
				V4L2_EXPOSURE_MANUAL, 0, V4L2_EXPOSURE_AUTO);
	ov5645->awb = v4l2_ctrl_new_std(&ov5645->ctrls, &ov5645_ctrl_ops,
				V4L2_CID_AUTO_WHITE_BALANCE, 0, 1, 1, 1);
	ov5645->pattern = v4l2_ctrl_new_std_menu_items(&ov5645->ctrls,
				&ov5645_ctrl_ops, V4L2_CID_TEST_PATTERN,
				ARRAY_SIZE(ov5645_test_pattern_menu) - 1, 0, 0,
				ov5645_test_pattern_menu);

	ov5645->sd.ctrl_handler = &ov5645->ctrls;

	if (ov5645->ctrls.error) {
		dev_err(dev, "%s: control initialization error %d\n",
		       __func__, ov5645->ctrls.error);
		ret = ov5645->ctrls.error;
		goto free_ctrl;
	}

	v4l2_i2c_subdev_init(&ov5645->sd, client, &ov5645_subdev_ops);
	ov5645->sd.flags |= V4L2_SUBDEV_FL_HAS_DEVNODE;
	ov5645->pad.flags = MEDIA_PAD_FL_SOURCE;
	ov5645->sd.internal_ops = &ov5645_subdev_internal_ops;

	ret = media_entity_init(&ov5645->sd.entity, 1, &ov5645->pad, 0);
	if (ret < 0) {
		dev_err(dev, "could not register media entity\n");
		goto free_ctrl;
	}

	ov5645->sd.dev = &client->dev;
	ret = v4l2_async_register_subdev(&ov5645->sd);
	if (ret < 0) {
		dev_err(dev, "could not register v4l2 device\n");
		goto free_entity;
	}

	ret = ov5645_s_power(&ov5645->sd, true);
	if (ret < 0) {
		dev_err(dev, "could not power up OV5645\n");
		goto unregister_subdev;
	}

	ret = ov5645_read_reg(ov5645, OV5645_CHIP_ID_HIGH_REG, &chip_id_high);
	if (ret < 0 || chip_id_high != OV5645_CHIP_ID_HIGH) {
		dev_err(dev, "could not read ID high\n");
		ret = -ENODEV;
		goto power_down;
	}else
		{
		dev_err(dev, "Sensor ID High:0x%x\n",chip_id_high);
	}
	
	ret = ov5645_read_reg(ov5645, OV5645_CHIP_ID_LOW_REG, &chip_id_low);
	if (ret < 0 || chip_id_low != OV5645_CHIP_ID_LOW) {
		dev_err(dev, "could not read ID low\n");
		ret = -ENODEV;
		goto power_down;
	}else
	{
		dev_err(dev, "Sensor ID Low:0x%x\n",chip_id_low);

	}

	dev_info(dev, "OV5645 detected at address 0x%02x\n", client->addr);

	ov5645_s_power(&ov5645->sd, false);

	return 0;

power_down:
	ov5645_s_power(&ov5645->sd, false);
unregister_subdev:
	v4l2_async_unregister_subdev(&ov5645->sd);
free_entity:
	media_entity_cleanup(&ov5645->sd.entity);
free_ctrl:
	v4l2_ctrl_handler_free(&ov5645->ctrls);

	return ret;
}


static int ov5645_remove(struct i2c_client *client)
{
	struct v4l2_subdev *sd = i2c_get_clientdata(client);
	struct ov5645 *ov5645 = to_ov5645(sd);

	v4l2_async_unregister_subdev(&ov5645->sd);
	media_entity_cleanup(&ov5645->sd.entity);
	v4l2_ctrl_handler_free(&ov5645->ctrls);

	return 0;
}


static const struct i2c_device_id ov5645_id[] = {
	{ "ov5645", 0 },
	{}
};
MODULE_DEVICE_TABLE(i2c, ov5645_id);

static const struct of_device_id ov5645_of_match[] = {
	{ .compatible = "ovti,ov5645" },
	{ /* sentinel */ }
};
MODULE_DEVICE_TABLE(of, ov5645_of_match);

static struct i2c_driver ov5645_i2c_driver = {
	.driver = {
		.of_match_table = of_match_ptr(ov5645_of_match),
		.name  = "ov5645",
	},
	.probe  = ov5645_probe,
	.remove = ov5645_remove,
	.id_table = ov5645_id,
};

module_i2c_driver(ov5645_i2c_driver);

MODULE_DESCRIPTION("Omnivision OV5645 Camera Driver");
MODULE_AUTHOR("Todor Tomov <todor.tomov@linaro.org>");
MODULE_LICENSE("GPL v2");
