Kevin-WSCU/96Boards-Camera/(commit log)

2016-10-15 Create Schematic
2016-10-16 ov5640 driver source code,updated the sensor setting and gio control (based on AiStarVsion MIPI adapter board)
2016-11-12 correct the i2c slave address change,this is the original one for 5640
    I think someone tried to change the i2c slave address of ov5640/5,submitted here.This will cause the boot failure for dragonboard410c,it;s weird i didn't see any log for that....
    [ov5645.c]
2016-11-29 Upload adapter board user guide and mipi module spec
2017-04-02 add dual ov5645 support for Dragonboard410C
    Dual sensor support for OV5645,based on AISTARVISION MIPI Adapter V2.0
2017-04-02 dual sensor support in device tree
2017-04-02 Single OV5645 sensor support
2017-04-03 add schematic for mipi adapter v2.0
2017-05-08 update release schematic
2017-07-02 upload single camera binary(from J3)
2017-07-09 Create readme
    ov7251 driver from RDI interface,MIPI raw dump
2017-07-09 ov7251 driver patch based on debian 16.09 release
2017-07-11 initial imx185 driver
2017-07-21 Update for sensor and doc release date
2017-07-29 upload boot.img for OV5645 front camera
    upload boot.img for OV5645 front camera
2017-08-07 sensor board for few modules
2017-08-07 Update driver and documents
2017-08-20 Update sensor board schematics
2017-08-27 Update README.md
    Dual camera support via IPEX connector
2017-08-27 Create Sensorboards
2017-09-24 Update driver status
2017-11-22 Create README
    Raspberry ov5647 camera module is supported on 15pin mipi csi2 interface of Adapter V2.0 Mezzanine board.
2017-11-22 ov5647 driver so lib
    push all so files to vendor/lib
2017-11-22 Create README
    Raspberry imx219 camera module is supported on mipi csi2 15pin interface of Adapter V2.0 Mezzanine board.
2017-12-27 Update user guide for even more sensors support
2018-01-08 misc boards
2018-01-29 Upload AISTAR-MIPI Bridge V1.2 Schematic
2018-04-28 update repo for MIPI adapter v2.1 schematic
