Kevin-WSCU/96Boards-Camera/(notices)

Notices in the files:
Pre-built/Debian_16.09/IMX185/imx185.c:
This program is free software; you can redistribute it and/or modify
it under the terms of the GNU General Public License as published by
the Free Software Foundation; either version 2 of the License, or
(at your option) any later version.
